CursedPrograms/NORA-Robot-v00/TODO.txt

[done] Implement wheel lock/unlock on the remote - It requires no Password like the webpage.

[done in code, not flashed] Implement speed control on the remote (6 slower, 7 faster, 10 % a press)

Replace the AHT10 sensor and connect it to 3.3V (physical/hardware modification, not code)

[done in code] Add voice response - MP3 lines track200-210 (make_voice.bat). Still to do: copy them to the SD card and upload the UNO sketch.

Add a buzzer

Use the light sensor to turn on the UV light when dark (and off when bright)

[done in code, not flashed: stops at 22 cm, slows from 40, slides off a side wall from 20 cm, only slides under 9 cm] Improve obstacle avoidance (currently inaccurate; the sides scrape walls). It should stop and strafe away if a left/right sensor gets too close to a wall. The stopping distance is also to small it runs into walls.

[done] Use the IR transmitter to steer MILA, KIDA01, WHIP (fleet link, /link?r=&c=, panel tabs)

[done] If not actively transmitting IR commands, continuously broadcast a signal telling other robots: "Hi, I am here" (beacon 0x47, round-robin every 2 s)

WiFi/Windows only — no Bluetooth serial transport (that needs separate serial-port code per platform), and no Linux/macOS HTTP backend (would need libcurl instead of WinHTTP). Both are legitimate follow-ups if you want them later.

[done] Only obey NORA's own IR remote (NEC 0x00) - noise was switching her into Line mode; mode changes record their source (msrc)

[done] Line mode stops for anything closer than 15 cm in front (she drove into a wall)

[done] Web page sends fast (TCP no-delay) - the 10 s send froze her loop and hid her from RIFT

UV BLINK may be restarting her (power dip?) - check if UV ON does it too; drive the UV LED through a transistor

Left ultrasonic reads -1 (no echo) - check its wiring

M:TRACK:<n> (play track n from the start) added to arduino.ino for RIFT's music together - compiles, NOT flashed yet: needs the user's OK (2026-10-14)
