CursedPrograms/NORA-Robot-v00/scripts/esp32/esp32.ino

#include <WiFi.h>
#include <HTTPClient.h>
// WiFi names, passwords and the wheel-lock password: secrets.h (git ignores it),
// else the placeholders in secrets.example.h.
#if __has_include("secrets.h")
#include "secrets.h"
#else
#include "secrets.example.h"
#endif
#include <WebServer.h>
#include <ESPmDNS.h>
#include <Preferences.h>
#include "fleet_bt.h"   // the fleet's one Bluetooth protocol: her whole web API over Bluetooth serial (RIFT/Fleet/esp32)
#include <IRremote.hpp>
#include "avatars.h"
#include "keys_page.h"   // the /keys page: generated from scripts/keymap.py
#include "fleet_near.h"      // ESP-NOW "I'm here" beacons: which robots are nearby, from signal strength
#include "fleet_stay.h"     // STAY CLOSE: keeping near RITA
#include "fleet_near_ble.h"  // ...and the same beacon over Bluetooth LE, so she and the Pi robots (KIDAs) hear each other
#include "fleet_radio.h"     // WiFi or Bluetooth (RIFT switches): all of it at once left her 3.7 KB and she rebooted forever
#include "talk_bf.h"  // the fleet's Brainfuck phrasebook (generated by RIFT/Fleet/brainfuck_talk.py)   // /avatar/<name>.jpg for the fleet-remote panel
#include <Wire.h>
#include <Adafruit_AHTX0.h>

// =====================
// BLUETOOTH
// =====================
// Pair with "NORA" from your phone, then use any Bluetooth serial /
// RC controller app. Single-character commands:
//   F=forward  B=backward  L=strafe left  R=strafe right
//   Q=turn left  E=turn right  S=stop
//   1=manual mode  2=auto mode  3=line mode
//   U=cycle UV     M=music play/pause  N=next track  P=prev track  X=music stop
//   K=lock motors (always allowed)
//   V + 4 chars=unlock motors (password, e.g. "V1234")
//   +=speed up  -=speed down  ?=print sensor + music status
//   H + "name:cap1,cap2" + newline = fleet heartbeat/register (mirrors the
//     HTTP /register the fleet registry below takes over WiFi — lets RIFT
//     or DREAM heartbeat over Bluetooth instead when their dashboards are
//     switched to that transport). Replies "OK" or "ERR".

// =====================
// WIFI
// =====================
// The fleet's ladder: RIFT > DREAM > NINA > TINA (the hub, the virtual bots)
// > NORACTL > WHIPCTL > KIDA01CTL > KIDA00CTL > ARMCTL (the PC controllers, in their bots' order)
// > NORA > WHIP > KIDA01 > KIDA00 > ARM > MILA (the real bots). Every
// robot joins the highest network it sees above itself; with none, it hosts its own
// and the fleet list (/register, /robots on :5000) so the ones below find each other.
// Above NORA are RIFT (FLEET_SSID, the router), DREAM, NINA, TINA and the controllers; everyone uses the
// fleet password. If neither is around she hosts NORA_AP_SSID (192.168.4.1) as before,
// and keeps looking: when a higher network shows up she restarts into it (parked only).
const char* ap_ssid = NORA_AP_SSID;
const char* ap_password = NORA_AP_PASSWORD;
const char* const ABOVE_NORA[] = { FLEET_SSID, "DREAM", "NINA", "TINA", "AURA", "NORACTL", "WHIPCTL", "KIDA01CTL", "KIDA00CTL", "ARMCTL" };   // highest first
const uint16_t RIFT_PORT = 5000;                             // the fleet list, on whoever hosts
const unsigned long FLEET_JOIN_MS = 20000;     // at boot: how long to try RIFT's network
const unsigned long RIFT_SCAN_MS = 30000;      // on her own network: look for RIFT this often
const unsigned long RIFT_REGISTER_MS = 10000;  // on RIFT's network: heartbeat (RIFT drops entries after 20 s)
const unsigned long NET_LOST_MS = 60000;       // the network above her, or its fleet list, silent this long: climb again
bool onRift = false;                           // joined a network above her (false = hosting her own)
int  joinedRank = -1;                          // which: 0 = RIFT, 1 = DREAM, 2 = NINA, 3 = TINA, 4+ = the controllers
WebServer server(5002);

// =====================
// MOTOR PINS
// =====================
#define ENA1 5
#define M1_1 16
#define M1_2 17

#define ENA2 23
#define M2_1 18
#define M2_2 19

#define ENB1 12
#define M3_1 13
#define M3_2 14

#define ENB2 27
#define M4_1 26
#define M4_2 25

// Forward declarations with default args (kept here only — the Arduino IDE
// auto-generates prototypes from the definitions below, and a default
// argument may only be specified once per translation unit).
void moveForward(int scale = 100);
void moveBackward(int scale = 100);
void strafeLeft(int scale = 100);
void strafeRight(int scale = 100);
void turnLeft(int scale = 100);
void turnRight(int scale = 100);
void stopMotors();
void setMotor(int ena, int pin1, int pin2, int s1, int s2, int speed, int scale = 100);
bool motorsMoving = false;   // any wheel driven right now (what she tells the fleet: parked or moving)
// What the UNO last reported about its SD card and music (-1 = an older UNO sketch that doesn't say)
int sdOk = -1, sdTracks = -1;
// The last IR frame heard, whatever it was (shown in /sensors, to see whether a remote is heard and what it sends)
unsigned long irFrames = 0;
String irLastProto = "";
uint16_t irLastAddr = 0;
uint16_t irLastCmd = 0;

// =====================
// LINE FOLLOWER (on ESP32)
// =====================
#define LF_LEFT 34
#define LF_MID 35
#define LF_RIGHT 39

// =====================
// UV LIGHT (on ESP32)
// =====================
#define UV_PIN 4

// =====================
// LIGHT + SOUND SENSORS
// =====================
// Both live on the Arduino now (A5 / pin 5) -- it has to poll the sound
// sensor tightly between ultrasonic pings to catch a clap reliably, which
// its loop is naturally suited for. It forwards smoothed light% and a
// latched sound-event flag over serial (LT / SND fields), parsed below in
// parseSensorLine(). The clap-count/double-clap timing itself still runs
// here, just fed by that flag instead of a local digitalRead edge.
//
// CLAP_BOOT_GRACE_MS: ignore that flag for the first few seconds after
// boot -- the Arduino's own startup chime plays right into the sound
// sensor and reads as a clap otherwise (see parseSensorLine()).
#define CLAP_BOOT_GRACE_MS 5000
int lightPct = 0;          // 0 = dark, 100 = bright
bool soundRecent = false;  // true if a sound was heard in the last 500ms
unsigned long lastSoundMs = 0;
unsigned long firstClapMs = 0;
int clapCount = 0;

// =====================
// TEMPERATURE / HUMIDITY (AHT10, I2C)
// =====================
// Wire.begin() with no args defaults to SDA=21 SCL=22 on the ESP32.
Adafruit_AHTX0 aht;
bool aht10Ok = false;  // if begin() failed, skip reads and leave -1 (matches ultrasonic's "no reading" convention -- NAN would serialize as invalid JSON and silently freeze the whole HUD)
float tempC = -1;
float humidity = -1;

// =====================
// IR RECEIVER (on ESP32)
// =====================
// Cheap NEC remote (see ir_mapping.txt for the full button dump). Data pin
// only — GPIO32 was the next free, non-strapping pin left on the board;
// power the receiver from 3.3V, not 5V, so its output never exceeds the
// ESP32's logic level.
// IR transmitter LED lives on GPIO33 (freed up now that the sound sensor
// moved to the Arduino). It carries the IDA link below.
#define IR_RECEIVE_PIN 32
#define IR_SEND_PIN 33

// =====================
// IDA LINK (NORA -> IDA over IR)
// =====================
// NORA relays drive commands to IDA, which only has an IR receiver. The link
// has its own protocol so nothing else in the fleet reacts to it: Samsung-
// format frames (38 kHz) with address IDA_LINK_ADDRESS, while every remote in
// the fleet is NEC (NORA) or Sony-style (IDA, MILA, WHIP). The command codes
// 0x48-0x4F are unused by all of those remotes too. IDA's side is
// runLinkCommand() in IDA-Robot-v00/scripts/IDA/IDA.ino;
// keep the two tables in step.
// Driving commands must be re-sent every ~150 ms while held (the web page,
// Python controller and BT 'I' prefix all do); IDA stops ~500 ms after they stop.
#define IDA_LINK_ADDRESS 0x0DA1
// The same link drives MILA, WHIP and KIDA-01 too, each on its own address
// (same command codes). Their receivers: MILA.ino and WHIP's esp32.ino
// runLinkCommand(), KIDA-01's arduino01 sketch (prints the IR lines the Pi
// already understands).
#define MILA_LINK_ADDRESS 0x0DA2
#define WHIP_LINK_ADDRESS 0x0DA3
#define KIDA_LINK_ADDRESS 0x0DA4
#define NIKA_LINK_ADDRESS 0x0DA5   // NIKA.ino: like MILA's, plus she listens for this beacon (her social drive)

// ---- Robots talking (liveliness; the real data goes over WiFi / the link) ----
// Every so often, when she isn't driving anyone, NORA says a phrase: she
// beeps it on her buzzer (BZ:TALK:n to the UNO; each phrase is a Brainfuck
// program from talk_bf.h, one tone per symbol) and, once she's finished,
// sends 0x40 + n over the link. IDA answers with her reply (IDA.ino hearNora()). Between phrases a
// silent beacon (0x47, "I am here") goes round-robin to every link robot, so
// they know she's near; IDA greets her when she comes back after a while.
// Every phrase is logged for /talk (and RIFT, later).
#define TALK_FIRST 0x40
#define TALK_BEACON 0x47
const char* const TALK_NAMES[7] = { "hello", "how are you", "happy", "curious", "sleepy", "play", "bye" };
bool chatOff = false;   // her chat switch (/talkmute?chat_off=): out of the conversations
const unsigned long TALK_QUIET_MS = 15000;   // no chatting within 15 s of driving a robot over the link
const unsigned long BEACON_EVERY_MS = 2000;  // one robot per beacon, so each hears it every 8 s
const int TALK_LOG_LEN = 12;
unsigned long talkLogMs[TALK_LOG_LEN];
uint16_t talkLogTo[TALK_LOG_LEN];
uint8_t talkLogPhrase[TALK_LOG_LEN];
int talkLogCount = 0, talkLogNext = 0;
unsigned long lastLinkDriveMs = 0;  // last drive command sent over the link
unsigned long nextTalkMs = 30000;
unsigned long nextBeaconMs = 0;
int beaconIndex = 0;
uint16_t pendingLinkAddr = 0;  // phrase to send over IR once NORA has finished saying it
uint8_t pendingLinkCode = 0;
unsigned long pendingLinkAt = 0;
#define LINK_FORWARD 0x48
#define LINK_BACKWARD 0x49
#define LINK_LEFT 0x4A
#define LINK_RIGHT 0x4B
#define LINK_STOP 0x4C
#define LINK_OBSTACLE 0x4D
#define LINK_MANUAL 0x4E
#define LINK_SPEED 0x4F
// The wheel lock, over the link: NORA can free (or lock) the wheels of a robot she drives.
// Each robot does it in its own way (IDA.ino, MILA.ino, WHIP's esp32.ino, KIDA-01's arduino01).
#define LINK_UNLOCK 0x50
#define LINK_LOCK 0x51

#define IR_UP 0x6
#define IR_LEFT 0x47
#define IR_DOWN 0x44
#define IR_RIGHT 0x40
#define IR_ENTER 0x7
#define IR_1 0x9
#define IR_2 0x1D
#define IR_3 0x1F
#define IR_4 0xD
#define IR_MUTE 0x56
#define IR_VOL_UP 0x3
#define IR_VOL_DOWN 0x2
#define IR_REPEAT 0x53
#define IR_PLAY_PAUSE 0xF
#define IR_STOP 0x42
#define IR_NEXT 0x1A
#define IR_PREV 0xE
#define IR_FFWD 0x1E
#define IR_REWIND 0xA
#define IR_5 0x19   // the wheel lock, on and off: one button, no PIN (the lock is a safety catch, not security)
#define IR_6 0x1B   // slower: speed down 10 %
#define IR_7 0x11   // faster: speed up 10 %

#define IR_DRIVE_TIMEOUT_MS 250  // stop if no drive repeat arrives within this long (no key-up event over IR)

bool irStrafe = true;  // Enter toggles Left/Right between strafe (true) and turn (false)
unsigned long irLastDriveMs = 0;
// Blended driving (/drive?f=&s=&t=): the controller resends it every 150 ms while held, so she
// stops by herself DRIVE_MIX_TIMEOUT_MS after the last one (a closed controller can't leave her running).
#define DRIVE_MIX_TIMEOUT_MS 500
unsigned long driveMixMs = 0;
// The same for /fw ... /turnR, which her page and the controllers resend every 150-200 ms: a page closed or a
// program gone mid-drive would otherwise leave her running. Longer: her one-client server can stall a resend.
#define WEB_DRIVE_TIMEOUT_MS 1500
unsigned long webDriveMs = 0;

// =====================
// DRIVE MODE
// =====================
enum DriveMode { MODE_MANUAL,
                 MODE_AUTO,
                 MODE_LINE,
                 MODE_IR,
                 MODE_MIND,     // her PC controller's LLM drives her (MIND MODE below)
                 MODE_FOLLOW,   // keeps a hand FOLLOW_CM from her front sonar (FOLLOW below)
                 MODE_STAY };   // keeps near RITA, in your hand (STAY CLOSE below)
DriveMode driveMode = MODE_MANUAL;
Stay stay;

// HELLO and DANCE (/act?do=, as WHIP's): a wiggle on the spot, a step at a time from loop(), so her
// web page and the IR keep working. Any stopMotors() ends it.
enum ShowMove { SHOW_NONE, SHOW_HELLO, SHOW_DANCE };
ShowMove showMove = SHOW_NONE;
int showStep = 0;
unsigned long showNextMs = 0;

// =====================
// MIND MODE (fleet TODO, section 10)
// =====================
// Her PC controller's LLM (mind.py) drives her one short move at a time. The mind host - a controller
// that can run it (mind.can_think()) - unlocks with /unlock?pw=<MOTOR_PASSWORD>&ctl=1 and checks in on
// /sensors?ctl=1; MIND mode only starts while it does, and ends (stop, back to MANUAL) 5 s after it goes
// quiet. /mind?act=fw|bw|left|right|turnL|turnR|stop&steps=1-4: MIND_STEP_MS per step, then stop. Her
// wheel lock and her manual wall stop (MANUAL_STOP_CM, any direction) hold in MIND too.
IPAddress mindHostIP(0, 0, 0, 0);
unsigned long mindHostSeen = 0;
const unsigned long MIND_HOST_TTL_MS = 5000;
const unsigned long MIND_STEP_MS = 400;
const int MIND_MAX_STEPS = 4;
unsigned long mindMoveUntil = 0;   // the current move ends here (0 = none)
int mindDir = -1;                  // the DIR_* it's heading, to stop at a wall on the way; -1 = turning
bool mindBlocked = false;          // the last move stopped at a wall
bool mindHostAlive() { return mindHostSeen && millis() - mindHostSeen < MIND_HOST_TTL_MS; }
#define MANUAL_STOP_CM 15.0  // closer than this blocks Manual/Remote driving and pauses Line mode

// =====================
// CALIBRATION & SPEED
// =====================
int cal[4] = { 255, 255, 255, 255 };
int speedPct = 100;
Preferences prefs;

// =====================
// FLEET TEXT MESSAGES
// =====================
// NORA has no display/speaker, so incoming "/message" text just lands in a
// small ring buffer that other fleet nodes (RIFT, DREAM) can poll via
// "/messages" — a lightweight message board rather than something acted on.
#define MESSAGE_LOG_SIZE 10
String messageLog[MESSAGE_LOG_SIZE];
int messageLogHead = 0;
int messageLogCount = 0;

String jsonEscape(const String& in) {
  String out;
  out.reserve(in.length() + 4);
  for (size_t i = 0; i < in.length(); i++) {
    char c = in[i];
    if (c == '"' || c == '\\') out += '\\';
    out += c;
  }
  return out;
}

// =====================
// MOTOR LOCK
// =====================
// Starts locked on every boot so a static-feature test session can never
// accidentally drive off a counter (this is why it exists — see incident).
// Locking is always allowed with no password; unlocking requires one,
// checked here in firmware so every client (web, pygame, raw BT/HTTP)
// is held to the same gate instead of trusting each app to enforce it.
bool motorLocked = true;

// === RADAR (passive imposter spotter) ===
// NORA listens to the WiFi around her and flags anything that is not one of
// our own networks as an "imposter". Passive only: she scans and reports,
// never connecting to or touching a network that is not hers.
const char* const FLEET_SSIDS[] = { "NORA", "MILA", "WHIP", "NIKA" };
// On-demand only: a WiFi scan channel-hops, which would disturb NORA's AP and
// her ESP-NOW proximity beacons, so she scans only when /radar is opened, and
// no more often than this.
const unsigned long RADAR_MIN_GAP_MS = 10000;
String radarJson = "{\"scanning\":false,\"nets\":[]}";
unsigned long lastRadarScan = 0;
bool radarInFlight = false;
bool radarRequested = false;

bool isFleetSsid(const String& s) {
  for (unsigned i = 0; i < sizeof(FLEET_SSIDS) / sizeof(FLEET_SSIDS[0]); i++) {
    if (s == FLEET_SSIDS[i]) return true;
  }
  return false;
}

String radarEscape(const String& in) {
  String out;
  for (unsigned i = 0; i < in.length(); i++) {
    char c = in[i];
    if (c == '"' || c == '\\') { out += '\\'; out += c; }
    else if (c == '\n' || c == '\r' || c == '\t') { out += ' '; }
    else out += c;
  }
  return out;
}

void radarLoop() {
  if (!radarInFlight && radarRequested && millis() - lastRadarScan >= RADAR_MIN_GAP_MS) {
    radarRequested = false;
    WiFi.scanNetworks(true, true);   // async, include hidden
    radarInFlight = true;
    lastRadarScan = millis();
    return;
  }
  if (radarInFlight) {
    int n = WiFi.scanComplete();
    if (n == WIFI_SCAN_RUNNING) return;
    if (n == WIFI_SCAN_FAILED)  { radarInFlight = false; return; }
    int imposters = 0;
    String j = "{\"scanning\":false,\"nets\":[";
    for (int i = 0; i < n; i++) {
      String ssid = WiFi.SSID(i);
      String shown = ssid.length() ? radarEscape(ssid) : "(hidden)";
      bool fleet = ssid.length() && isFleetSsid(ssid);
      if (!fleet) imposters++;
      if (i) j += ",";
      j += "{\"ssid\":\"" + shown + "\",\"rssi\":" + String(WiFi.RSSI(i)) +
           ",\"imposter\":" + String(fleet ? "false" : "true") + "}";
    }
    j += "],\"imposters\":" + String(imposters) + "}";
    radarJson = j;
    WiFi.scanDelete();
    radarInFlight = false;
  }
}

// Fleet heartbeat over Bluetooth ('H' below) — same buffer-until-newline
// shape as the password flow above, just terminated by '\n' instead of a
// fixed length since the payload ("name:cap1,cap2") is variable-length.

// =====================
// AUTONOMOUS STATE
// =====================
#define DIR_FRONT 0
#define DIR_RIGHT 1
#define DIR_BACK 2
#define DIR_LEFT 3

enum AutoState { AUTO_COOLDOWN,
                 AUTO_MOVING };
AutoState autoState = AUTO_COOLDOWN;
int autoDir = DIR_FRONT;
unsigned long autoCooldown = 0;

// boxed-in tracking for AutonomousMode() — global (not function-static) so
// entering Auto mode can reset it; otherwise a stale timestamp from a past
// stuck episode could fire an escape turn immediately on re-entry
unsigned long autoStuckSinceMs = 0;
bool autoEscaping = false;
unsigned long autoEscapeUntilMs = 0;

// =====================
// LINE FOLLOWER STATE
// =====================
// global (not function-static) so entering Line mode can reset it —
// otherwise a stale "lost the line" timestamp from a past run could fire
// an immediate stop on re-entry instead of the intended grace period
int lineLastTurn = 1;
unsigned long lineLostSinceMs = 0;

// =====================
// FLEET REGISTRY (port 5000)
// =====================
// NORA is the always-on node at a fixed address, so she's the natural
// place for robots (and a fleet manager like RIFT, if one's running) to
// find each other, instead of every app brute-force-scanning the subnet.
//
//   GET  /ping      -> liveness check
//   POST /register  -> body: name, type, capabilities (comma-separated)
//   GET  /robots    -> {"authority": "...", "robots": [...]}
//
// If something registers with type "fleet_manager" (e.g. RIFT), NORA
// treats it as the fleet's source of truth: she keeps quietly bookkeeping
// whoever else registers, but stops *surfacing* her own roster in
// /robots — callers get pointed at the authority instead. The moment
// the authority's heartbeat lapses (it closed, crashed, or the network
// dropped), NORA reclaims the role automatically and starts serving her
// own roster again. No explicit handoff needed either direction.
#define FLEET_MAX 8
#define FLEET_TTL_MS 20000  // drop an entry (or the authority) after this long without a heartbeat

struct FleetEntry {
  bool used = false;
  String name;
  String type;
  String capabilities;  // as given, comma-separated
  IPAddress ip;
  unsigned long lastSeenMs = 0;
};

FleetEntry fleet[FLEET_MAX];
WebServer fleetServer(5000);

String authorityName = "NORA";
unsigned long authorityExpiresMs = 0;  // 0 = NORA herself is the authority

// =====================
// SENSOR VALUES
// =====================
float front_cm = -1, left_cm = -1, back_cm = -1, right_cm = -1;
int lf_l = 0, lf_m = 0, lf_r = 0;
String serialBuffer = "";

// =====================
// MUSIC STATE (reported by Arduino)
// =====================
int musicTrack = 100;  // current track number
int musicState = 0;    // 0=stopped 1=playing 2=paused

// =====================
// UV STATE
// =====================
int uvMode = 0;  // 0=off 1=on 2=blink
bool uvBlinkState = false;
unsigned long lastUVBlink = 0;

// =====================
// BUZZER NOTIFICATIONS
// =====================
// The buzzer itself is on the Arduino (pin 10), but the state it needs to
// react to (mode/UV/lock/speed) all lives here -- so every place that
// changes one of those calls the matching notify*() right after, and it
// travels over the same serial link as the M:*/V:* commands.
void notifyMode() {
  if (driveMode == MODE_FOLLOW || driveMode == MODE_STAY) {   // the UNO's mode lines are 0-3: she says hello instead
    Serial.println("BZ:TALK:0");
    return;
  }
  if (driveMode == MODE_MIND) {   // the UNO's mode lines are 0-3; "Mind mode." is phrase-book line 11
    Serial.println("SAY:11");
    return;
  }
  Serial.print("BZ:MODE:");
  Serial.println((int)driveMode);
}
void notifyUv() {
  Serial.print("BZ:UV:");
  Serial.println(uvMode);
}
void notifyLock() {
  Serial.print("BZ:LOCK:");
  Serial.println(motorLocked ? 1 : 0);
}
void notifySpeed() {
  Serial.print("BZ:SPD:");
  Serial.println(speedPct);
}

// Every mode change goes through here, and remembers who asked for it
// ("web", "bt", "ir") -- shown as "msrc" in /sensors and BT '?', so a mode
// nobody chose can be traced back to where it came from.
String modeSource = "boot";

void setDriveMode(DriveMode m, const String& src) {
  driveMode = m;
  modeSource = src;
  stopMotors();
  if (m == MODE_AUTO) {
    autoState = AUTO_COOLDOWN;
    autoCooldown = 0;
    autoStuckSinceMs = 0;
    autoEscaping = false;
  } else if (m == MODE_LINE) {
    lineLostSinceMs = 0;
  } else if (m == MODE_IR) {
    irLastDriveMs = 0;
  } else if (m == MODE_STAY) {
    stayStart(stay);
  }
  notifyMode();
}

// =====================
// SETUP
// =====================
void handleRoot();   // after the page: Arduino's prototype maker can lose it in that much text

void setup() {
  Serial.begin(9600);  // link to Arduino (sensors in, music commands out)

  prefs.begin("cal", true);
  cal[0] = prefs.getInt("m1", 255);
  cal[1] = prefs.getInt("m2", 255);
  cal[2] = prefs.getInt("m3", 255);
  cal[3] = prefs.getInt("m4", 255);
  speedPct = prefs.getInt("spd", 100);
  prefs.end();
  prefs.begin("talk", true);   // her Brainfuck talking muted? (/talkmute, RIFT's Fleet/talk_mute.py)
  talkMuted = prefs.getBool("muted", false);
  chatOff = prefs.getBool("chatoff", false);
  prefs.end();

  randomSeed(esp_random());  // the conversations shouldn't repeat every boot
  fleetRadioBegin();   // WiFi (default) or Bluetooth, as RIFT last set it; on WiFi Bluetooth's RAM goes back
  if (fleetRadioWifi()) setupWiFi();   // RIFT's network, or her own (ESP-NOW rides on whichever)
  else fleetRadioNoWifi();             // Bluetooth: no WiFi at all (MILA and NIKA can't reach her then)
  IrReceiver.begin(IR_RECEIVE_PIN, DISABLE_LED_FEEDBACK);
  // The transmitter makes its carrier with an LEDC channel and the receiver
  // samples on a hardware timer, so they don't contend on the ESP32.
  // idaSend() still pauses the receiver for each frame so NORA doesn't
  // decode her own transmission.
  IrSender.begin(IR_SEND_PIN);

  Wire.begin();
  aht10Ok = aht.begin();  // if missing, tempC/humidity just stay -1

  pinMode(ENA1, OUTPUT);
  pinMode(M1_1, OUTPUT);
  pinMode(M1_2, OUTPUT);
  pinMode(ENA2, OUTPUT);
  pinMode(M2_1, OUTPUT);
  pinMode(M2_2, OUTPUT);
  pinMode(ENB1, OUTPUT);
  pinMode(M3_1, OUTPUT);
  pinMode(M3_2, OUTPUT);
  pinMode(ENB2, OUTPUT);
  pinMode(M4_1, OUTPUT);
  pinMode(M4_2, OUTPUT);

  pinMode(LF_LEFT, INPUT);
  pinMode(LF_MID, INPUT);
  pinMode(LF_RIGHT, INPUT);

  pinMode(UV_PIN, OUTPUT);
  digitalWrite(UV_PIN, LOW);

  // Manual movement
  server.on("/fw", []() {
    if (driveMode == MODE_MANUAL) { moveForward(); webDriveMs = millis(); }
    server.send(200, "text/plain", "OK");
  });
  server.on("/bw", []() {
    if (driveMode == MODE_MANUAL) { moveBackward(); webDriveMs = millis(); }
    server.send(200, "text/plain", "OK");
  });
  server.on("/left", []() {
    if (driveMode == MODE_MANUAL) { strafeLeft(); webDriveMs = millis(); }
    server.send(200, "text/plain", "OK");
  });
  server.on("/right", []() {
    if (driveMode == MODE_MANUAL) { strafeRight(); webDriveMs = millis(); }
    server.send(200, "text/plain", "OK");
  });
  server.on("/turnL", []() {
    if (driveMode == MODE_MANUAL) { turnLeft(); webDriveMs = millis(); }
    server.send(200, "text/plain", "OK");
  });
  server.on("/turnR", []() {
    if (driveMode == MODE_MANUAL) { turnRight(); webDriveMs = millis(); }
    server.send(200, "text/plain", "OK");
  });
  server.on("/stop", []() {
    if (driveMode == MODE_MANUAL) stopMotors();
    server.send(200, "text/plain", "OK");
  });
  // Blended: f forward, s sideways (+ left), t turn (+ anticlockwise), each -1..1, all at once
  // (W+A drives forward and slides left; W+Q curves). Resent while held; see DRIVE_MIX_TIMEOUT_MS.
  server.on("/drive", []() {
    if (driveMode == MODE_MANUAL) {
      driveMix(constrain(server.arg("f").toFloat(), -1.0f, 1.0f), constrain(server.arg("s").toFloat(), -1.0f, 1.0f),
               constrain(server.arg("t").toFloat(), -1.0f, 1.0f));
      driveMixMs = millis();
    }
    server.send(200, "text/plain", "OK");
  });

  // Mode switching
  server.on("/modeManual", []() {
    setDriveMode(MODE_MANUAL, "web");
    server.send(200, "text/plain", "OK");
  });
  server.on("/modeAuto", []() {
    setDriveMode(MODE_AUTO, "web");
    server.send(200, "text/plain", "OK");
  });
  server.on("/modeLine", []() {
    setDriveMode(MODE_LINE, "web");
    server.send(200, "text/plain", "OK");
  });
  server.on("/modeIR", []() {
    setDriveMode(MODE_IR, "web");
    server.send(200, "text/plain", "OK");
  });
  server.on("/modeFollow", []() {
    setDriveMode(MODE_FOLLOW, "web");
    server.send(200, "text/plain", "OK");
  });
  server.on("/modeStay", []() {
    setDriveMode(MODE_STAY, "web");
    server.send(200, "text/plain", "OK");
  });
  server.on("/act", []() {         // ?do=hello|dance, in MANUAL, as WHIP's
    const String what = server.arg("do");
    if (what != "hello" && what != "dance") { server.send(400, "text/plain", "hello|dance"); return; }
    if (driveMode != MODE_MANUAL) { server.send(409, "text/plain", "only in MANUAL"); return; }
    startShow(what == "hello" ? SHOW_HELLO : SHOW_DANCE);
    server.send(200, "text/plain", "OK");
  });
  server.on("/modeMind", []() {    // the MIND button (her page, her controller): only while her mind's controller is here
    if (!mindHostAlive()) { server.send(409, "text/plain", "no mind controller running"); return; }
    setDriveMode(MODE_MIND, "mind");
    server.send(200, "text/plain", "OK");
  });
  server.on("/mode", []() {        // the fleet's /mode?m=mind (and her other modes by name)
    String m = server.arg("m");
    if (m == "mind") {
      if (!mindHostAlive()) { server.send(409, "text/plain", "no mind controller running"); return; }
      setDriveMode(MODE_MIND, "mind");
    } else if (m == "manual") setDriveMode(MODE_MANUAL, "web");
    else if (m == "auto") setDriveMode(MODE_AUTO, "web");
    else if (m == "line") setDriveMode(MODE_LINE, "web");
    else if (m == "ir") setDriveMode(MODE_IR, "web");
    else if (m == "follow") setDriveMode(MODE_FOLLOW, "web");
    else if (m == "stay") setDriveMode(MODE_STAY, "web");
    else { server.send(400, "text/plain", "manual|auto|line|ir|follow|stay|mind"); return; }
    server.send(200, "text/plain", "OK");
  });
  server.on("/unlock", []() {      // her mind's controller says it's here (her PIN = her motor password)
    if (server.arg("pw") != MOTOR_PASSWORD) { server.send(403, "application/json", "{\"ok\":false}"); return; }
    if (server.arg("ctl") == "1") { mindHostIP = server.client().remoteIP(); mindHostSeen = millis(); }
    server.send(200, "application/json", "{\"ok\":true}");
  });
  server.on("/mind", []() {
    if (!mindHostAlive() || server.client().remoteIP() != mindHostIP) { server.send(403, "text/plain", "LOCKED"); return; }
    if (driveMode != MODE_MIND) { server.send(409, "application/json", "{\"ok\":false,\"error\":\"not in mind mode\"}"); return; }
    String act = server.arg("act");
    int steps = server.hasArg("steps") ? constrain(server.arg("steps").toInt(), 1, MIND_MAX_STEPS) : 1;
    if (act == "stop") { stopMotors(); mindMoveUntil = 0; server.send(200, "application/json", "{\"ok\":true}"); return; }
    if (motorLocked) { server.send(200, "application/json", "{\"ok\":false,\"locked\":true}"); return; }
    int dir = act == "fw" ? DIR_FRONT : act == "bw" ? DIR_BACK : act == "left" ? DIR_LEFT : act == "right" ? DIR_RIGHT : -1;
    if (dir < 0 && act != "turnL" && act != "turnR") { server.send(400, "application/json", "{\"ok\":false,\"error\":\"bad act\"}"); return; }
    mindBlocked = dir >= 0 && blockedInDir(dir);
    if (mindBlocked) { server.send(200, "application/json", "{\"ok\":false,\"blocked\":true}"); return; }
    if (act == "fw") moveForward();
    else if (act == "bw") moveBackward();
    else if (act == "left") strafeLeft();
    else if (act == "right") strafeRight();
    else if (act == "turnL") turnLeft();
    else turnRight();
    mindDir = dir;
    mindMoveUntil = millis() + steps * MIND_STEP_MS;
    server.send(200, "application/json", "{\"ok\":true}");
  });

  // UV
  server.on("/uvOff", []() {
    uvMode = 0;
    notifyUv();
    server.send(200, "text/plain", "OK");
  });
  server.on("/uvOn", []() {
    uvMode = 1;
    notifyUv();
    server.send(200, "text/plain", "OK");
  });
  server.on("/uvBlink", []() {
    uvMode = 2;
    notifyUv();
    server.send(200, "text/plain", "OK");
  });

  // Motor lock — lock is free, unlock needs the password
  server.on("/motorlockOn", []() {
    motorLocked = true;
    stopMotors();
    notifyLock();
    server.send(200, "text/plain", "OK");
  });
  server.on("/motorlockOff", []() {
    if (server.hasArg("pw") && server.arg("pw") == MOTOR_PASSWORD) {
      motorLocked = false;
      notifyLock();
      server.send(200, "text/plain", "OK");
    } else {
      server.send(403, "text/plain", "DENIED");
    }
  });

  // Music player -> forwarded to Arduino over serial
  server.on("/muPlay", []() {
    Serial.println("M:PLAY");
    server.send(200, "text/plain", "OK");
  });
  server.on("/muNext", []() {
    Serial.println("M:NEXT");
    server.send(200, "text/plain", "OK");
  });
  server.on("/muPrev", []() {
    Serial.println("M:PREV");
    server.send(200, "text/plain", "OK");
  });
  server.on("/muStop", []() {
    Serial.println("M:STOP");
    server.send(200, "text/plain", "OK");
  });

  // Generic serial passthrough — lets fleet controllers (RIFT, DREAM)
  // send any command string straight to the onboard Arduino over UART,
  // beyond the hardcoded M:*/UV:* commands above.
  server.on("/serial", []() {
    if (!server.hasArg("cmd")) {
      server.send(400, "text/plain", "missing 'cmd'");
      return;
    }
    Serial.println(server.arg("cmd"));
    server.send(200, "text/plain", "OK");
  });

  // Text message board (see MESSAGE_LOG_SIZE above).
  server.on("/message", HTTP_POST, []() {
    if (!server.hasArg("text")) {
      server.send(400, "text/plain", "missing 'text'");
      return;
    }
    messageLog[messageLogHead] = server.arg("text");
    messageLogHead = (messageLogHead + 1) % MESSAGE_LOG_SIZE;
    if (messageLogCount < MESSAGE_LOG_SIZE) messageLogCount++;
    server.send(200, "text/plain", "OK");
  });
  server.on("/messages", HTTP_GET, []() {
    String json = "[";
    for (int i = 0; i < messageLogCount; i++) {
      int idx = (messageLogHead - messageLogCount + i + MESSAGE_LOG_SIZE) % MESSAGE_LOG_SIZE;
      if (i > 0) json += ",";
      json += "\"" + jsonEscape(messageLog[idx]) + "\"";
    }
    json += "]";
    server.send(200, "application/json", json);
  });

  // Calibration
  server.on("/setcal", []() {
    if (server.hasArg("m1")) cal[0] = constrain(server.arg("m1").toInt(), 0, 255);
    if (server.hasArg("m2")) cal[1] = constrain(server.arg("m2").toInt(), 0, 255);
    if (server.hasArg("m3")) cal[2] = constrain(server.arg("m3").toInt(), 0, 255);
    if (server.hasArg("m4")) cal[3] = constrain(server.arg("m4").toInt(), 0, 255);
    server.send(200, "text/plain", "OK");
  });
  server.on("/setspeed", []() {
    if (server.hasArg("v")) {
      speedPct = constrain(server.arg("v").toInt(), 0, 100);
      notifySpeed();
    }
    server.send(200, "text/plain", "OK");
  });
  server.on("/savecal", []() {
    prefs.begin("cal", false);
    prefs.putInt("m1", cal[0]);
    prefs.putInt("m2", cal[1]);
    prefs.putInt("m3", cal[2]);
    prefs.putInt("m4", cal[3]);
    prefs.putInt("spd", speedPct);
    prefs.end();
    server.send(200, "text/plain", "OK");
  });
  server.on("/getcal", []() {
    String json = "{\"m1\":" + String(cal[0]) + ",\"m2\":" + String(cal[1]) + ",\"m3\":" + String(cal[2]) + ",\"m4\":" + String(cal[3]) + ",\"spd\":" + String(speedPct) + "}";
    server.send(200, "application/json", json);
  });

  // /status is the fleet's name for it (fleet talk's "ask", the same JSON). rev: her settings in one
  // number (FNV-1a, as WHIP's), so a page or program sees at once that something changed elsewhere.
  auto sensorsJson = []() {
    if (server.arg("ctl") == "1" && mindHostSeen && server.client().remoteIP() == mindHostIP) mindHostSeen = millis();
    uint32_t rev = 2166136261u;
    const int settings[] = { (int)driveMode, speedPct, uvMode, motorLocked ? 1 : 0, cal[0], cal[1], cal[2], cal[3] };
    for (int v : settings) { rev ^= (uint32_t)v; rev *= 16777619u; }
    String json = "{\"rev\":" + String(rev) + ",\"mindHost\":" + String(mindHostAlive() ? 1 : 0) +
                  ",\"mindSteps\":" + String(mindMoveUntil ? (int)((mindMoveUntil - millis() + MIND_STEP_MS - 1) / MIND_STEP_MS) : 0) +
                  ",\"blocked\":" + String(mindBlocked ? 1 : 0) + ",\"F\":" + String(front_cm, 1) + ",\"L\":" + String(left_cm, 1) + ",\"B\":" + String(back_cm, 1) + ",\"R\":" + String(right_cm, 1) + ",\"lfl\":" + String(lf_l) + ",\"lfm\":" + String(lf_m) + ",\"lfr\":" + String(lf_r) + ",\"mode\":" + String((int)driveMode) + ",\"dir\":" + String(autoDir) + ",\"uv\":" + String(uvMode) + ",\"mt\":" + String(musicTrack) + ",\"ms\":" + String(musicState) + ",\"lt\":" + String(lightPct) + ",\"snd\":" + String(soundRecent ? 1 : 0) + ",\"lock\":" + String(motorLocked ? 1 : 0) + ",\"moving\":" + String(motorsMoving ? 1 : 0) + ",\"spd\":" + String(speedPct) + ",\"temp\":" + String(tempC, 1) + ",\"hum\":" + String(humidity, 1) + ",\"msrc\":\"" + modeSource + "\"" +
                  ",\"sd\":" + String(sdOk) + ",\"nt\":" + String(sdTracks) +
                  ",\"irn\":" + String(irFrames) + ",\"irp\":\"" + irLastProto + "\",\"ira\":" + String(irLastAddr) +
                  ",\"irc\":" + String(irLastCmd) +
                  ",\"distance_cm\":" + String(front_cm, 1) +                                       // her front, for RITA's STATS
                  ",\"wifi_rssi\":" + String(WiFi.status() == WL_CONNECTED ? WiFi.RSSI() : 0) +   // her signal (0: she hosts)
                  ",\"bluetooth\":" + String(fleetRadioBluetooth() && fleetBtConnected() ? 1 : 0) + ",\"radio\":\"" + (fleetRadioBluetooth() ? "bluetooth" : "wifi") + "\"" + ",\"talk_muted\":" + (talkMuted ? "true" : "false") + ",\"chat_off\":" + (chatOff ? "true" : "false") + "}";
    server.send(200, "application/json", json);
  };
  server.on("/sensors", sensorsJson);
  server.on("/status", sensorsJson);

  // ---- IDA link: drive IDA through the IR transmitter (works in every mode,
  // and isn't affected by NORA's motor lock -- they're IDA's motors) ----
  server.on("/ida", []() {
    if (server.hasArg("c") && idaCommand(server.arg("c"))) server.send(200, "text/plain", "OK");
    else server.send(400, "text/plain", "use /ida?c=fw|bw|left|right|stop|auto|manual|speed");
  });
  // ---- fleet link: the same commands for any robot NORA can reach over IR ----
  server.on("/link", []() {
    uint16_t addr = linkAddress(server.arg("r"));
    if (addr && server.hasArg("c") && linkCommand(addr, server.arg("c"))) server.send(200, "text/plain", "OK");
    else server.send(400, "text/plain", "use /link?r=ida|mila|whip|kida&c=fw|bw|left|right|stop|auto|manual|speed");
  });
  // ---- robots talking: GET /talk = the log; /talk?r=ida&p=hello = say it now ----
  server.on("/talk", []() {
    if (server.hasArg("p")) {
      uint16_t addr = linkAddress(server.hasArg("r") ? server.arg("r") : String("ida"));
      int phrase = talkPhrase(server.arg("p"));
      if (!addr || phrase < 0) {
        server.send(400, "text/plain", "use /talk?r=ida|mila|whip|kida&p=hello|how|happy|curious|sleepy|play|bye");
        return;
      }
      talkSay(addr, phrase);
    }
    server.send(200, "application/json", talkJson());
  });
  // ---- /chirp?u=<0-13>: say an utterance on NORA's buzzer (RIFT's WiFi
  // conversations; she doesn't send anything over IR for these) ----
  // ---- /talkmute: her two talk switches (RIFT's Fleet/talk_mute.py, the
  // switches on her page), kept across restarts. ?on=0|1|toggle: sound (she
  // chats, but the buzzer stays quiet; the UNO hears BZ:MUTE:<0|1>, again every
  // 5 s with BZ:PROX). ?chat_off=0|1|toggle: out of the conversations (RIFT's,
  // and her own IR chats with IDA) ----
  server.on("/talkmute", []() {
    if (server.hasArg("on") || server.hasArg("chat_off")) {
      if (server.hasArg("on")) talkMuted = server.arg("on") == "toggle" ? !talkMuted : server.arg("on").toInt() != 0;
      if (server.hasArg("chat_off")) chatOff = server.arg("chat_off") == "toggle" ? !chatOff : server.arg("chat_off").toInt() != 0;
      prefs.begin("talk", false);
      prefs.putBool("muted", talkMuted);
      prefs.putBool("chatoff", chatOff);
      prefs.end();
      Serial.print("BZ:MUTE:");
      Serial.println(talkMuted ? 1 : 0);
    }
    server.send(200, "application/json", talkSwitchJson());
  });
  server.on("/chirp", []() {
    if (chatOff) {
      server.send(409, "application/json", "{\"ok\":false,\"reason\":\"chat_off\"}");
      return;
    }
    if (talkMuted) {   // said, without the buzzer
      server.send(200, "application/json", "{\"ok\":true,\"silent\":true}");
      return;
    }
    int u = server.hasArg("u") ? server.arg("u").toInt() : -1;
    if (!server.hasArg("u") || u < 0 || u >= TALK_UTTERANCES) {
      server.send(400, "text/plain", "use /chirp?u=0-13");
      return;
    }
    Serial.print("BZ:TALK:");
    Serial.println(u);
    server.send(200, "application/json", "{\"ok\":true,\"text\":\"" + String(TALK_TEXT[u]) + "\",\"bf\":\"" + talkProgram(u) + "\",\"ms\":" + String(talkDurationMs(u)) + "}");
  });
  server.on("/avatar/ida.jpg", []() {
    sendAvatar(AVATAR_IDA, sizeof(AVATAR_IDA));
  });
  server.on("/avatar/mila.jpg", []() {
    sendAvatar(AVATAR_MILA, sizeof(AVATAR_MILA));
  });
  server.on("/avatar/whip.jpg", []() {
    sendAvatar(AVATAR_WHIP, sizeof(AVATAR_WHIP));
  });
  server.on("/avatar/kida.jpg", []() {
    sendAvatar(AVATAR_KIDA, sizeof(AVATAR_KIDA));
  });
  server.on("/avatar/nika.jpg", []() {
    sendAvatar(AVATAR_NIKA, sizeof(AVATAR_NIKA));
  });

  // which robots are nearby (ESP-NOW signal strength), nearest first
  server.on("/radar", []() {
    radarRequested = true;   // trigger a fresh scan on the next loop
    server.send(200, "application/json", radarJson);
  });
  server.on("/near", []() {
    server.send(200, "application/json", fleetNearStatusJson());
  });

  server.on("/keys", []() { server.send_P(200, "text/html", KEYS_HTML); });   // every key, button and letter (keys_page.h)
  server.on("/", handleRoot);
  server.begin();
  fleetRadioRoutes(server, MOTOR_PASSWORD);   // /radio: RIFT moves her to Bluetooth and back
  if (fleetRadioBluetooth()) {
    fleetBtBegin("NORA", 5002);   // Bluetooth "NORA": her whole web API over it
    fleetNearBleBegin("NORA");    // and "I'm here" over BLE, in place of ESP-NOW
    return;                       // no fleet list or nora.local without WiFi
  }
  if (MDNS.begin("nora")) MDNS.addService("http", "tcp", 5002);   // nora.local, as MILA and NIKA have

  setupFleetServer();
}

// =====================
// LOOP
// =====================
void loop() {
  // what she tells the other robots: driving herself, driven by you, or parked
  bool selfDriving = driveMode == MODE_STAY || driveMode == MODE_AUTO || driveMode == MODE_LINE || driveMode == MODE_MIND || driveMode == MODE_FOLLOW;
  fleetNearSetState((motorLocked || (!motorsMoving && !selfDriving)) ? FLEET_PARKED
                    : selfDriving ? FLEET_DRIVING : FLEET_USER);

  // The UNO's "something's close" tone only while she's moving and unlocked:
  // tell it when that changes, and every 5 s in case it rebooted.
  static int proxSent = -1;
  static unsigned long proxSentMs = 0;
  int proxNow = (!motorLocked && (motorsMoving || selfDriving)) ? 1 : 0;
  if (proxNow != proxSent || millis() - proxSentMs > 5000) {
    Serial.print("BZ:PROX:");
    Serial.println(proxNow);
    Serial.print("BZ:MUTE:");    // her talking muted? (the UNO keeps no settings of its own)
    Serial.println(talkMuted ? 1 : 0);
    proxSent = proxNow;
    proxSentMs = millis();
  }
  if (fleetRadioWifi()) fleetNearLoop();   // ESP-NOW on WiFi,
  else fleetNearBleLoop();                  // the BLE beacon on Bluetooth
  radarLoop();
  server.handleClient();
  if (fleetRadioWifi()) {
    fleetServer.handleClient();
    fleetNetworkLoop();
  }
  handleIR();
  readSerialSensors();

  lf_l = digitalRead(LF_LEFT);
  lf_m = digitalRead(LF_MID);
  lf_r = digitalRead(LF_RIGHT);

  unsigned long now = millis();
  talkTick(now);

  // IR has no key-up event — a held button just keeps resending, and
  // releasing it simply stops the resends. So if we're driving off the IR
  // remote and haven't seen a repeat in a while, treat that as "released".
  if (driveMode == MODE_IR && irLastDriveMs != 0 && now - irLastDriveMs > IR_DRIVE_TIMEOUT_MS) {
    stopMotors();
    irLastDriveMs = 0;
  }
  if (driveMixMs != 0 && now - driveMixMs > DRIVE_MIX_TIMEOUT_MS) {   // /drive went quiet: let go
    driveMixMs = 0;
    if (driveMode == MODE_MANUAL) stopMotors();
  }
  if (webDriveMs != 0 && now - webDriveMs > WEB_DRIVE_TIMEOUT_MS) {   // /fw ... went quiet: let go
    webDriveMs = 0;
    if (driveMode == MODE_MANUAL) stopMotors();
  }

  // ---- Sound recency decay (the event itself is latched in parseSensorLine) ----
  soundRecent = (now - lastSoundMs) < 500;

  // ---- Single clap (confirmed once the 0.8s double-clap window passes with
  // no second clap) -> play music. Can't fire this the instant a clap is
  // seen, or it'd also fire on the first half of every double clap.
  // Guarded on musicState so it only starts/resumes -- M:PLAY toggles to
  // pause if sent while already playing, which isn't what "1 clap = play"
  // should do. ----
  if (clapCount == 1 && now - firstClapMs > 800) {
    if (musicState != 1) Serial.println("M:PLAY");  // 1 = already playing
    clapCount = 0;
  }

  // ---- Temperature / humidity (AHT10) ----
  static unsigned long lastAhtMs = 0;
  if (aht10Ok && now - lastAhtMs >= 500) {
    sensors_event_t humEvt, tempEvt;
    aht.getEvent(&humEvt, &tempEvt);
    tempC = tempEvt.temperature;
    humidity = humEvt.relative_humidity;
    lastAhtMs = now;
  }

  if (uvMode == 0) {
    digitalWrite(UV_PIN, LOW);
  } else if (uvMode == 1) {
    digitalWrite(UV_PIN, HIGH);
  } else if (now - lastUVBlink >= 300) {
    uvBlinkState = !uvBlinkState;
    digitalWrite(UV_PIN, uvBlinkState ? HIGH : LOW);
    lastUVBlink = now;
  }

  if (driveMode == MODE_AUTO) AutonomousMode(front_cm, left_cm, back_cm, right_cm);
  else if (driveMode == MODE_LINE) LineFollowerMode(lf_l, lf_m, lf_r);
  else if (driveMode == MODE_FOLLOW) FollowMode(front_cm);
  else if (driveMode == MODE_STAY) StayMode(front_cm, left_cm, right_cm);
  else if (showMove != SHOW_NONE) showTick();
  else if (driveMode == MODE_MIND) {
    if (!mindHostAlive()) {
      mindMoveUntil = 0;
      setDriveMode(MODE_MANUAL, "mind gone");   // stops her
    } else if (mindMoveUntil && ((long)(now - mindMoveUntil) >= 0 || (mindDir >= 0 && blockedInDir(mindDir)) || motorLocked)) {
      if (mindDir >= 0 && blockedInDir(mindDir)) mindBlocked = true;
      mindMoveUntil = 0;
      stopMotors();
    }
  }
}

// =====================
// FOLLOW (WHIP's follow-me): keep a hand 30 cm from her front sonar
// =====================
const float FOLLOW_CM = 30;
const float FOLLOW_DEADBAND_CM = 4;   // close enough: stand
const float FOLLOW_LOST_CM = 80;      // nothing nearer than this: nobody to follow, stand

void FollowMode(float front) {
  const float e = front - FOLLOW_CM;
  const int dir = e > 0 ? DIR_FRONT : DIR_BACK;
  if (front <= 0 || front > FOLLOW_LOST_CM || fabs(e) <= FOLLOW_DEADBAND_CM || blockedInDir(dir)) {
    if (motorsMoving) stopMotors();
    return;
  }
  const int scale = constrain(45 + (int)fabs(e) * 2, 45, 80);   // slower as the hand gets close
  if (e > 0) moveForward(scale);
  else moveBackward(scale);
}

// =====================
// STAY CLOSE: near RITA, in your hand (fleet_stay.h)
// =====================
const int STAY_SCALE = 55;

// Her four ultrasonics and her mecanum wheels: she slows near things, slides round them toward the
// side with more room (still facing RITA's signal), and backs out of a corner (fleet_stay.h)
void StayMode(float front, float left, float right) {
  float rssi = -100;
  const bool heard = fleetNearHeard(STAY_PEER, STAY_LOST_MS, &rssi);
  const StaySight sight = { front, left, right, true };
  switch (stayStepSmart(stay, heard, rssi, sight, millis())) {
    case STAY_WALK:        moveForward(STAY_SCALE);           break;
    case STAY_CREEP:       moveForward(STAY_SCALE * 2 / 3);   break;   // something ahead: carefully
    case STAY_LEFT:        turnLeft(STAY_SCALE);              break;
    case STAY_RIGHT:       turnRight(STAY_SCALE);             break;
    case STAY_SLIDE_LEFT:  strafeLeft(STAY_SCALE);            break;
    case STAY_SLIDE_RIGHT: strafeRight(STAY_SCALE);           break;
    case STAY_BACK:        moveBackward(STAY_SCALE * 2 / 3);  break;
    default:               if (motorsMoving) stopMotors();
  }
}

// =====================
// HELLO and DANCE
// =====================
const int SHOW_HELLO_STEPS = 6;   // a wiggle from side to side
const int SHOW_DANCE_STEPS = 12;  // spin left, spin right, slide left, slide right
const int SHOW_STEP_MS = 280;
const int SHOW_SCALE = 65;

void startShow(ShowMove m) {
  stopMotors();
  showMove = m;
  showStep = 0;
  showNextMs = 0;
  Serial.print("BZ:TALK:");
  Serial.println(m == SHOW_HELLO ? 0 : 2);   // "hello" / "happy", on her buzzer
}

void showTick() {
  if ((long)(millis() - showNextMs) < 0) return;
  const bool hello = showMove == SHOW_HELLO;
  if (showStep >= (hello ? SHOW_HELLO_STEPS : SHOW_DANCE_STEPS)) {
    stopMotors();
    return;
  }
  showNextMs = millis() + SHOW_STEP_MS;
  const int beat = hello ? (showStep % 2) + 2 : showStep % 4;
  showStep++;
  // the moves check the walls themselves: blocked, they stop her, and that ends the show
  if (beat == 0) turnLeft(SHOW_SCALE);
  else if (beat == 1) turnRight(SHOW_SCALE);
  else if (beat == 2) strafeLeft(SHOW_SCALE);
  else strafeRight(SHOW_SCALE);
}

// =====================
// IR REMOTE COMMANDS
// =====================
// Driving (D-pad + Enter) only takes effect in MODE_IR — in every other
// mode those buttons are inert so they can't fight the website/BT driver
// or the autonomous/line logic. Mode switching, music, and volume/mute
// always work no matter which drive mode is active.
// Sends one IDA link frame. The receiver is paused while it goes out, and
// any reflection that still sneaks in is dropped in handleIR().
void linkSend(uint16_t address, uint8_t command) {
  IrReceiver.stop();
  IrSender.sendSamsung(address, command, 0);
  IrReceiver.start();
}

void idaSend(uint8_t command) {
  linkSend(IDA_LINK_ADDRESS, command);
}

// Link robot by name or BT letter -> its address, 0 if unknown.
uint16_t linkAddress(String r) {
  r.toLowerCase();
  if (r == "ida" || r == "i") return IDA_LINK_ADDRESS;
  if (r == "mila" || r == "m") return MILA_LINK_ADDRESS;
  if (r == "whip" || r == "w") return WHIP_LINK_ADDRESS;
  if (r == "kida" || r == "k") return KIDA_LINK_ADDRESS;
  if (r == "nika" || r == "n") return NIKA_LINK_ADDRESS;
  return 0;
}

bool isLinkAddress(uint16_t a) {
  return a >= IDA_LINK_ADDRESS && a <= NIKA_LINK_ADDRESS;
}

void sendAvatar(const uint8_t* jpg, size_t len) {
  server.client().setNoDelay(true);  // same slow-send fix as handleRoot()
  server.sendHeader("Cache-Control", "max-age=86400");
  server.send_P(200, "image/jpeg", (PGM_P)jpg, len);
}

// Link command by name, as used by /ida?c=... and the BT 'I' prefix.
// Returns false for an unknown name.
bool idaCommand(const String& c) {
  return linkCommand(IDA_LINK_ADDRESS, c);
}

// Link command by name or BT letter, sent to the robot at address.
bool linkCommand(uint16_t address, const String& c) {
  uint8_t code;
  if (c == "fw" || c == "F") code = LINK_FORWARD;
  else if (c == "bw" || c == "B") code = LINK_BACKWARD;
  else if (c == "left" || c == "L") code = LINK_LEFT;
  else if (c == "right" || c == "R") code = LINK_RIGHT;
  else if (c == "stop" || c == "S") code = LINK_STOP;
  else if (c == "auto" || c == "O") code = LINK_OBSTACLE;
  else if (c == "manual" || c == "W") code = LINK_MANUAL;
  else if (c == "speed" || c == "X") code = LINK_SPEED;
  else if (c == "unlock" || c == "U") code = LINK_UNLOCK;
  else if (c == "lock" || c == "K") code = LINK_LOCK;
  else return false;
  linkSend(address, code);
  lastLinkDriveMs = millis();
  return true;
}

const char* linkName(uint16_t address) {
  switch (address) {
    case IDA_LINK_ADDRESS: return "IDA";
    case MILA_LINK_ADDRESS: return "MILA";
    case WHIP_LINK_ADDRESS: return "WHIP";
    case KIDA_LINK_ADDRESS: return "KIDA";
    case NIKA_LINK_ADDRESS: return "NIKA";
  }
  return "?";
}

// How long saying utterance u takes (ms), symbol by symbol.
unsigned long talkDurationMs(uint8_t u) {
  unsigned long ms = 0;
  for (uint16_t n = 0;; n++) {
    char c = talkSymbol(u, n);
    if (!c) break;
    ms += bfToneMs(c) + TALK_GAP_MS;
  }
  return ms;
}

// Say phrase (0-6) to the robot at address: beep it now, send it over IR
// once she's finished (so the answer doesn't talk over her), log it.
void talkSay(uint16_t address, uint8_t phrase) {
  if (phrase > 6) return;
  Serial.print("BZ:TALK:");
  Serial.println(phrase);
  pendingLinkAddr = address;
  pendingLinkCode = TALK_FIRST + phrase;
  pendingLinkAt = millis() + talkDurationMs(phrase) + 150;
  talkLogMs[talkLogNext] = millis();
  talkLogTo[talkLogNext] = address;
  talkLogPhrase[talkLogNext] = phrase;
  talkLogNext = (talkLogNext + 1) % TALK_LOG_LEN;
  if (talkLogCount < TALK_LOG_LEN) talkLogCount++;
}

// Phrase by name ("hello", "play"...) or number, -1 if unknown.
int talkPhrase(String p) {
  p.toLowerCase();
  for (int i = 0; i < 7; i++)
    if (p == TALK_NAMES[i]) return i;
  if (p == "how") return 1;
  if (p.length() == 1 && isDigit(p[0]) && p[0] <= '6') return p[0] - '0';
  return -1;
}

// Called every loop: chat now and then, and keep the beacon going.
void talkTick(unsigned long now) {
  if (pendingLinkAddr && now >= pendingLinkAt) {
    linkSend(pendingLinkAddr, pendingLinkCode);
    pendingLinkAddr = 0;
    nextBeaconMs = now + 5000;  // leave room for the answer
  }
  if (pendingLinkAddr) return;
  if (now - lastLinkDriveMs < TALK_QUIET_MS) return;  // busy driving someone
  if (irLastDriveMs != 0) return;                     // being driven by the IR remote: keep the receiver free
  if (now >= nextTalkMs && !chatOff) {   // chat off: no chats of her own (the beacon goes on)
    // mostly greetings and good moods; "bye" and "sleepy" now and then
    static const uint8_t PICK[] = { 0, 0, 1, 1, 2, 2, 3, 3, 5, 5, 4, 6 };
    talkSay(IDA_LINK_ADDRESS, PICK[random(sizeof(PICK))]);
    nextTalkMs = now + random(30000, 90000);
    return;
  }
  if (now >= nextBeaconMs) {
    static const uint16_t ROBOTS[] = { IDA_LINK_ADDRESS, MILA_LINK_ADDRESS, WHIP_LINK_ADDRESS, KIDA_LINK_ADDRESS, NIKA_LINK_ADDRESS };
    linkSend(ROBOTS[beaconIndex], TALK_BEACON);
    beaconIndex = (beaconIndex + 1) % 5;
    nextBeaconMs = now + BEACON_EVERY_MS;
  }
}

// Utterance u's Brainfuck program, as a String.
String talkProgram(uint8_t u) {
  String bf;
  for (uint16_t n = 0;; n++) {
    char c = talkSymbol(u, n);
    if (!c) break;
    bf += c;
  }
  return bf;
}

// /talk as JSON, oldest first: {"now":ms,"log":[{"ms":..,"from":"NORA","to":"IDA",
// "said":"hello","text":"hi","bf":"++++++++[>+++++++++++++<-]>.+."},..]}
String talkJson() {
  String j = "{\"now\":" + String(millis()) + ",\"log\":[";
  for (int i = 0; i < talkLogCount; i++) {
    int k = (talkLogNext - talkLogCount + i + TALK_LOG_LEN) % TALK_LOG_LEN;
    if (i) j += ",";
    j += "{\"ms\":" + String(talkLogMs[k]) + ",\"from\":\"NORA\",\"to\":\"" + linkName(talkLogTo[k]) + "\",\"said\":\"" + TALK_NAMES[talkLogPhrase[k]] + "\",\"text\":\"" + TALK_TEXT[talkLogPhrase[k]] + "\",\"bf\":\"" + talkProgram(talkLogPhrase[k]) + "\"}";
  }
  return j + "],\"talk_muted\":" + (talkMuted ? "true" : "false") + ",\"chat_off\":" + (chatOff ? "true" : "false") + "}";
}

// Her two talk switches, as /talkmute answers
String talkSwitchJson() {
  return String("{\"talk_muted\":") + (talkMuted ? "true" : "false") + ",\"chat_off\":" + (chatOff ? "true" : "false") + "}";
}

void handleIR() {
  if (!IrReceiver.decode()) return;

  irFrames++;   // everything heard, obeyed or not
  irLastProto = String(getProtocolString(IrReceiver.decodedIRData.protocol));
  irLastAddr  = IrReceiver.decodedIRData.address;
  irLastCmd   = IrReceiver.decodedIRData.command;

  // our own link frames (a reflection off a nearby wall) aren't commands for NORA
  if (IrReceiver.decodedIRData.protocol == SAMSUNG && isLinkAddress(IrReceiver.decodedIRData.address)) {
    IrReceiver.resume();
    return;
  }

  // Only NORA's own remote (NEC, address 0x00 -- see ir_mapping.txt) is
  // obeyed. IRremote also turns noise into made-up frames of other protocols,
  // and those could land on 1-4 and switch her mode with nobody pressing
  // anything.
  if (IrReceiver.decodedIRData.protocol == NEC && IrReceiver.decodedIRData.address == 0x00) {
    bool isRepeat = IrReceiver.decodedIRData.flags & IRDATA_FLAGS_IS_REPEAT;
    uint8_t cmd = IrReceiver.decodedIRData.command;

    switch (cmd) {
      // ---- driving: IR remote mode only. Repeats (button held) keep it
      // moving; the timeout watchdog in loop() stops it on release. ----
      case IR_UP:
        if (driveMode == MODE_IR) {
          moveForward();
          irLastDriveMs = millis();
        }
        break;
      case IR_DOWN:
        if (driveMode == MODE_IR) {
          moveBackward();
          irLastDriveMs = millis();
        }
        break;
      case IR_LEFT:
        if (driveMode == MODE_IR) {
          irStrafe ? strafeLeft() : turnLeft();
          irLastDriveMs = millis();
        }
        break;
      case IR_RIGHT:
        if (driveMode == MODE_IR) {
          irStrafe ? strafeRight() : turnRight();
          irLastDriveMs = millis();
        }
        break;

      default:
        if (isRepeat) break;  // everything below only fires on the initial press

        switch (cmd) {
          case IR_ENTER:
            if (driveMode == MODE_IR) irStrafe = !irStrafe;
            break;

          // ---- modes (always allowed) ----
          case IR_1:
            setDriveMode(MODE_MANUAL, "ir");
            break;
          case IR_2:
            setDriveMode(MODE_AUTO, "ir");
            break;
          case IR_3:
            setDriveMode(MODE_LINE, "ir");
            break;
          case IR_4:
            setDriveMode(MODE_IR, "ir");
            break;

          // ---- the wheel lock: 5 frees her wheels, 5 again locks them (always allowed) ----
          case IR_5:
            motorLocked = !motorLocked;
            if (motorLocked) stopMotors();
            notifyLock();
            break;

          // ---- speed: 6 slower, 7 faster, 10 % a press (always allowed; like Bluetooth's - / +) ----
          case IR_6:
            speedPct = constrain(speedPct - 10, 10, 100);
            notifySpeed();
            break;
          case IR_7:
            speedPct = constrain(speedPct + 10, 10, 100);
            notifySpeed();
            break;

          // ---- music, forwarded to the Arduino (always allowed) ----
          case IR_PLAY_PAUSE: Serial.println("M:PLAY"); break;
          case IR_STOP: Serial.println("M:STOP"); break;
          case IR_NEXT: Serial.println("M:NEXT"); break;
          case IR_PREV: Serial.println("M:PREV"); break;
          case IR_FFWD: Serial.println("M:NEXT"); break;  // no seek hardware — treat as skip
          case IR_REWIND: Serial.println("M:PREV"); break;
          case IR_REPEAT: Serial.println("M:REPEAT"); break;

          // ---- volume, forwarded to the Arduino (always allowed) ----
          case IR_VOL_UP: Serial.println("V:UP"); break;
          case IR_VOL_DOWN: Serial.println("V:DOWN"); break;
          case IR_MUTE: Serial.println("V:MUTE"); break;
        }
        break;
    }
  }

  IrReceiver.resume();
}

// =====================
// READ ARDUINO SERIAL
// =====================
void readSerialSensors() {
  while (Serial.available()) {
    char c = Serial.read();
    if (c == '\n') {
      parseSensorLine(serialBuffer);
      serialBuffer = "";
    } else if (c != '\r') {
      serialBuffer += c;
    }
  }
}

void parseSensorLine(String line) {
  // The fleet-wide handshake: a PC on her USB port asking "WHO". (The UNO
  // hears the reply too and ignores it.)
  if (line == "WHO") {
    Serial.println("I am Nora");
    return;
  }
  // Only the UNO's status lines carry readings; anything else would zero them.
  if (!line.startsWith("F:")) return;
  auto extractFloat = [&](String key) -> float {
    int idx = line.indexOf(key + ":");
    if (idx == -1) return -1;
    int start = idx + key.length() + 1;
    int end = line.indexOf(',', start);
    String val = (end == -1) ? line.substring(start) : line.substring(start, end);
    return val.toFloat();
  };

  front_cm = extractFloat("F");
  left_cm = extractFloat("L");
  back_cm = extractFloat("B");
  right_cm = extractFloat("R");

  float mt = extractFloat("MT");
  float ms = extractFloat("MS");
  if (mt >= 0) musicTrack = (int)mt;
  if (ms >= 0) musicState = (int)ms;

  float lt = extractFloat("LT");
  if (lt >= 0) lightPct = (int)lt;
  float sd = extractFloat("SD"), nt = extractFloat("NT");
  if (sd >= 0) sdOk = (int)sd;
  if (nt >= 0) sdTracks = (int)nt;

  // ---- Sound event: edge-detected + debounced on the Arduino already,
  // we just run the clap-count timing off of this latched flag.
  // 1 clap  -> play music  (fired from loop() once the window times out
  //            with no second clap -- see there for why)
  // 2 claps within 0.8s -> stop music (fires immediately, no need to wait:
  //            seeing the 2nd clap already confirms it wasn't a single)
  //
  // Ignored for the first CLAP_BOOT_GRACE_MS after boot: the Arduino's
  // startup chime (track000.mp3) plays right into the same board's sound
  // sensor, which reads its own speaker as a "clap" and would otherwise
  // fire M:PLAY the moment the chime ends -- music starting on its own
  // right after the boot sound, with nobody actually clapping. ----
  if (millis() < CLAP_BOOT_GRACE_MS) return;
  if (extractFloat("SND") == 1) {
    unsigned long now = millis();
    lastSoundMs = now;
    if (clapCount == 0 || now - firstClapMs > 800) {
      clapCount = 1;
      firstClapMs = now;
    } else {
      clapCount++;
    }
    if (clapCount >= 2) {
      Serial.println("M:STOP");
      clapCount = 0;
    }
  }
}

// =====================
// LINE FOLLOWER MODE
// =====================
// Same shape of fix as AutonomousMode(): gentler turns instead of full-speed
// pivots (less zigzag along the line), and a fail-safe stop instead of
// spinning in place forever once the line is genuinely lost.
void LineFollowerMode(int l, int m, int r) {
  const int TURN_SCALE = 65;           // gentler than a full-speed pivot
  const unsigned long LOST_MS = 1000;  // give up and stop after this long off-line

  // A line can run straight into a wall, and a dark floor reads as "line"
  // on all three sensors -- so wait here rather than drive into it.
  if (front_cm > 0 && front_cm < MANUAL_STOP_CM) {
    stopMotors();
    return;
  }
  // Another robot very close with right of way: wait on the line (no turning off it).
  if (fleetGiveWay(false) != FLEET_GO) {
    stopMotors();
    return;
  }

  int pattern = (l << 2) | (m << 1) | r;
  switch (pattern) {
    case 0b010:
    case 0b111:
    case 0b101:  // both outer sensors on line, middle off — wide line/intersection, keep going
      lineLostSinceMs = 0;
      moveForward();
      break;
    case 0b110:
    case 0b100:
      lineLastTurn = -1;
      lineLostSinceMs = 0;
      turnLeft(TURN_SCALE);
      break;
    case 0b011:
    case 0b001:
      lineLastTurn = 1;
      lineLostSinceMs = 0;
      turnRight(TURN_SCALE);
      break;
    case 0b000:
      if (lineLostSinceMs == 0) lineLostSinceMs = millis();
      if (millis() - lineLostSinceMs > LOST_MS) stopMotors();
      else if (lineLastTurn < 0) turnLeft(TURN_SCALE);
      else turnRight(TURN_SCALE);
      break;
    default: moveForward(); break;
  }
}

// =====================
// AUTONOMOUS MODE
// =====================
void moveDir(int dir, int scale) {
  switch (dir) {
    case DIR_FRONT: moveForward(scale); break;
    case DIR_RIGHT: strafeRight(scale); break;
    case DIR_BACK: moveBackward(scale); break;
    case DIR_LEFT: strafeLeft(scale); break;
  }
}

// Auto mode: drive `dir` at `scale` %, sliding away from a wall beside her (the two sensors across
// her way), so the sides stop scraping. Further than SIDE_CM: straight on. Closer: she slides
// away the more, the closer it is; under SIDE_CRITICAL_CM she stops going on and only slides away.
// Mecanum wheels can do both at once (driveMix).
const float SIDE_CM = 20.0;
const float SIDE_CRITICAL_CM = 9.0;
void moveDirAway(int dir, int scale, const float dist[4]) {
  const int a = (dir + 1) % 4, b = (dir + 3) % 4;   // the sensors either side of her way
  const float da = dist[a], db = dist[b], near = min(da, db);
  if (near >= SIDE_CM) { moveDir(dir, scale); return; }
  // along: front +f, back -f, left +s, right -s
  static const float F[4] = { 1, 0, -1, 0 }, S[4] = { 0, -1, 0, 1 };
  const float push = (SIDE_CM - near) / (SIDE_CM - SIDE_CRITICAL_CM);   // 0 at SIDE_CM, 1 at critical
  const float go = near < SIDE_CRITICAL_CM ? 0 : scale / 100.0f;
  const float away = 0.6f * min(push, 1.0f);
  const int from = da < db ? a : b;                  // slide away from the nearer wall
  driveMix(go * F[dir] - away * F[from], go * S[dir] - away * S[from], 0);
}

int clearestDir(float dist[4]) {
  int best = 0;
  for (int d = 1; d < 4; d++)
    if (dist[d] > dist[best]) best = d;
  return best;
}

// Reactive omnidirectional avoidance. Beyond the original bang-bang
// controller, this adds:
//   - EMA smoothing per sensor so single noisy pings don't flip decisions
//   - cautious (not "infinite") handling of dropped/out-of-range readings,
//     since a failed echo can mean "too close" just as easily as "clear"
//   - a switch hysteresis margin so it won't flap between two directions
//     that read almost the same distance
//   - a slow-down band instead of full speed all the way to CRITICAL
//   - an escape turn when genuinely boxed in, instead of freezing forever
void AutonomousMode(float front, float left, float back, float right) {
  // Another robot close by (fleet_near.h): give way if it has right of way,
  // and drive slower with wider margins while one is near.
  FleetYieldPhase yieldNow = fleetGiveWay(true);
  if (yieldNow == FLEET_WAIT) {
    stopMotors();
    return;
  }
  if (yieldNow == FLEET_TURN) {
    turnLeft(60);
    return;
  }
  const bool caution = fleetNearAdvice() != FLEET_CLEAR;
  // she ran into walls at 15 / 28 (2026-10-28): stop sooner, slow down sooner
  const float DANGER = caution ? 50.0 : 40.0;
  const float CRITICAL = caution ? 30.0 : 22.0;
  const int CRUISE = caution ? 60 : 100;   // % speed when the way is clear
  const float SWITCH_MARGIN = 8.0;  // new dir must clear the old one by this much
  const float UNKNOWN_CM = 45.0;    // cautious guess once a sensor goes stale (just past DANGER)
  const int CREEP_SCALE = 55;       // % speed while inside the DANGER band
  const unsigned long STALE_MS = 800;
  const unsigned long STUCK_MS = 1200;
  const unsigned long ESCAPE_MS = 400;

  unsigned long now = millis();

  // ---- per-sensor smoothing with cautious dropout handling ----
  static float filtered[4] = { UNKNOWN_CM, UNKNOWN_CM, UNKNOWN_CM, UNKNOWN_CM };
  static unsigned long lastGoodMs[4] = { 0, 0, 0, 0 };
  float raw[4] = { front, right, back, left };  // matches DIR_FRONT/RIGHT/BACK/LEFT

  for (int d = 0; d < 4; d++) {
    if (raw[d] > 0) {
      filtered[d] = (lastGoodMs[d] == 0) ? raw[d] : (filtered[d] * 0.5 + raw[d] * 0.5);
      lastGoodMs[d] = now;
    } else if (now - lastGoodMs[d] > STALE_MS) {
      // no valid echo in a while: could be "clear" or could be "too close to
      // hear the echo" — assume neither, treat it as merely borderline
      filtered[d] = UNKNOWN_CM;
    }
    // else: a brief dropout — keep trusting the last smoothed value
  }
  float dist[4] = { filtered[0], filtered[1], filtered[2], filtered[3] };

  // ---- boxed-in escape: turn toward the more open side instead of freezing ----
  if (autoEscaping) {
    if (now < autoEscapeUntilMs) return;
    autoEscaping = false;
    stopMotors();
    autoState = AUTO_COOLDOWN;
    autoCooldown = now + 150;
    autoStuckSinceMs = 0;
    return;
  }

  if (autoState == AUTO_COOLDOWN) {
    if (now < autoCooldown) return;
    int best = clearestDir(dist);
    if (dist[best] < DANGER) {
      if (autoStuckSinceMs == 0) autoStuckSinceMs = now;
      if (now - autoStuckSinceMs > STUCK_MS) {
        if (dist[DIR_LEFT] >= dist[DIR_RIGHT]) turnLeft(CREEP_SCALE);
        else turnRight(CREEP_SCALE);
        autoEscaping = true;
        autoEscapeUntilMs = now + ESCAPE_MS;
        return;
      }
      autoCooldown = now + 300;
      return;
    }
    autoStuckSinceMs = 0;
    autoDir = best;
    moveDirAway(autoDir, CRUISE, dist);
    autoState = AUTO_MOVING;
    return;
  }

  // AUTO_MOVING
  float cur = dist[autoDir];
  if (cur < CRITICAL) {
    stopMotors();
    autoState = AUTO_COOLDOWN;
    autoCooldown = now + 250;
  } else if (cur < DANGER) {
    int best = clearestDir(dist);
    if (best != autoDir && dist[best] > dist[autoDir] + SWITCH_MARGIN && dist[best] > DANGER) {
      stopMotors();
      autoDir = best;
      moveDirAway(autoDir, CRUISE, dist);
      autoState = AUTO_COOLDOWN;
      autoCooldown = now + 150;
    } else {
      moveDirAway(autoDir, CREEP_SCALE, dist);  // getting close — creep instead of full speed
    }
  } else {
    moveDirAway(autoDir, CRUISE, dist);  // clear again — resume cruising speed
  }
}

// =====================
// FLEET REGISTRY LOGIC
// =====================
void fleetPrune() {
  unsigned long now = millis();
  for (int i = 0; i < FLEET_MAX; i++) {
    if (fleet[i].used && now - fleet[i].lastSeenMs > FLEET_TTL_MS) fleet[i].used = false;
  }
  if (authorityExpiresMs != 0 && now > authorityExpiresMs) {
    authorityName = "NORA";  // authority's heartbeat lapsed — reclaim the role
    authorityExpiresMs = 0;
  }
}

void fleetRegister(const String& name, const String& type, const String& caps, IPAddress ip) {
  unsigned long now = millis();
  int slot = -1;
  for (int i = 0; i < FLEET_MAX; i++) {
    if (fleet[i].used && fleet[i].name == name) {
      slot = i;
      break;
    }  // re-register = heartbeat
  }
  if (slot == -1) {
    for (int i = 0; i < FLEET_MAX; i++)
      if (!fleet[i].used) {
        slot = i;
        break;
      }
  }
  if (slot == -1) return;  // registry full — stale entries free up via TTL on their own

  fleet[slot].used = true;
  fleet[slot].name = name;
  fleet[slot].type = type;
  fleet[slot].capabilities = caps;
  fleet[slot].ip = ip;
  fleet[slot].lastSeenMs = now;

  if (type == "fleet_manager") {
    authorityName = name;
    authorityExpiresMs = now + FLEET_TTL_MS;
  }
}

// "a, b,c" -> ["a","b","c"]
String fleetCapsToJsonArray(const String& caps) {
  String out = "[";
  int start = 0;
  bool first = true;
  while (start <= (int)caps.length()) {
    int comma = caps.indexOf(',', start);
    String item = (comma == -1) ? caps.substring(start) : caps.substring(start, comma);
    item.trim();
    if (item.length()) {
      if (!first) out += ",";
      out += "\"" + item + "\"";
      first = false;
    }
    if (comma == -1) break;
    start = comma + 1;
  }
  out += "]";
  return out;
}

// ---- The fleet's network --------------------------------------------------
IPAddress myIP() { return onRift ? WiFi.localIP() : WiFi.softAPIP(); }

// Index in ABOVE_NORA of the highest of those networks in the last scan, or -1.
int bestAbove(int n) {
  int best = -1;
  for (int i = 0; i < n; i++)
    for (int r = 0; r < (int)(sizeof(ABOVE_NORA) / sizeof(ABOVE_NORA[0])); r++)
      if (WiFi.SSID(i) == ABOVE_NORA[r] && (best < 0 || r < best)) best = r;
  return best;
}

void setupWiFi() {
  WiFi.mode(WIFI_STA);
  WiFi.setAutoReconnect(true);
  int n = WiFi.scanNetworks();
  int rank = bestAbove(n);
  WiFi.scanDelete();
  if (rank < 0) rank = 0;   // nothing seen: still give RIFT a try (it may be slow to show up)
  for (; rank < (int)(sizeof(ABOVE_NORA) / sizeof(ABOVE_NORA[0])); rank++) {
    WiFi.begin(ABOVE_NORA[rank], FLEET_PASSWORD);
    unsigned long start = millis();
    while (WiFi.status() != WL_CONNECTED && millis() - start < FLEET_JOIN_MS) delay(250);
    if (WiFi.status() == WL_CONNECTED) {
      onRift = true;
      joinedRank = rank;
      fleetNearBegin("NORA", WIFI_IF_STA);
      return;
    }
    WiFi.disconnect(false);
  }
  WiFi.disconnect(false);
  WiFi.setAutoReconnect(false);
  WiFi.mode(WIFI_AP_STA);   // AP for the robots; STA only so she can scan for RIFT
  WiFi.softAP(ap_ssid, ap_password, 1, 0, 8);   // channel 1, visible, up to 8 robots (the default is 4)
  onRift = false;
  fleetNearBegin("NORA", WIFI_IF_AP);   // she hosts the network, so ESP-NOW rides on her AP's channel
}

// On a network above her: tell its fleet list she's here, like every other robot,
// and on a lower one keep an eye out for a higher one. On her own: look for either now and then.
// Moving up is a restart, only while she's parked.
void fleetNetworkLoop() {
  static unsigned long lastMs = 0;
  static unsigned long lastScanMs = 0;
  if (onRift && joinedRank > 0 && millis() - lastScanMs > 2 * RIFT_SCAN_MS) {   // not on RIFT: is a higher one back?
    lastScanMs = millis();
    int n = WiFi.scanComplete();
    if (n == WIFI_SCAN_FAILED) WiFi.scanNetworks(true);
    else if (n >= 0) {
      int best = bestAbove(n);
      WiFi.scanDelete();
      if (best >= 0 && best < joinedRank && !motorsMoving && driveMode != MODE_AUTO && driveMode != MODE_LINE) ESP.restart();
    }
  }
  if (onRift) {
    // Still connected? Is the host still answering? Every heartbeat tells: no WiFi, or no fleet list
    // that takes her /register, for NET_LOST_MS and she starts over (a restart: climb, else host).
    static unsigned long goneSince = 0;
    bool up = WiFi.status() == WL_CONNECTED;
    if (!up && !goneSince) goneSince = millis();
    if (goneSince && millis() - goneSince > NET_LOST_MS
        && !motorsMoving && driveMode != MODE_AUTO && driveMode != MODE_LINE) ESP.restart();
    if (millis() - lastMs < RIFT_REGISTER_MS || !up) return;
    lastMs = millis();
    HTTPClient http;
    http.setTimeout(1500);
    http.begin(String("http://") + WiFi.gatewayIP().toString() + ":" + RIFT_PORT + "/register");   // whoever hosts
    http.addHeader("Content-Type", "application/x-www-form-urlencoded");
    int code = http.POST("name=NORA&type=omni&capabilities=obstacle_avoidance,line_follow,uv_light,music,ir_link,web:5002,talk:5002");
    http.end();
    if (code == 200) goneSince = 0;
    else if (!goneSince) goneSince = millis();
    return;
  }
  if (millis() - lastMs < RIFT_SCAN_MS) return;
  lastMs = millis();
  int n = WiFi.scanComplete();
  if (n == WIFI_SCAN_FAILED) { WiFi.scanNetworks(true); return; }   // start one; read it next time
  if (n < 0) return;                                                // still scanning
  bool seen = bestAbove(n) >= 0;
  WiFi.scanDelete();
  if (seen && !motorsMoving && driveMode != MODE_AUTO && driveMode != MODE_LINE) ESP.restart();
}

void setupFleetServer() {
  fleetServer.on("/ping", []() {
    fleetServer.send(200, "text/plain", "NORA alive");
  });

  fleetServer.on("/register", HTTP_POST, []() {
    String name = fleetServer.hasArg("name") ? fleetServer.arg("name") : "";
    String type = fleetServer.hasArg("type") ? fleetServer.arg("type") : "unknown";
    String caps = fleetServer.hasArg("capabilities") ? fleetServer.arg("capabilities") : "";
    if (name.length() == 0) {
      fleetServer.send(400, "text/plain", "missing 'name'");
      return;
    }
    fleetRegister(name, type, caps, fleetServer.client().remoteIP());
    fleetServer.send(200, "text/plain", "OK");
  });

  fleetServer.on("/robots", HTTP_GET, []() {
    fleetPrune();

    String json = "{\"authority\":\"" + authorityName + "\",\"robots\":[";
    json += "{\"name\":\"NORA\",\"type\":\"omni\",\"ip\":\"" + myIP().toString() + "\",\"capabilities\":[\"obstacle_avoidance\",\"line_follow\",\"uv_light\",\"music\"]}";

    // While someone else is the live authority, don't also author a
    // competing roster — just point callers at her. Entries registered
    // during that time are still tracked quietly so there's no gap the
    // instant NORA reclaims the role.
    if (authorityExpiresMs == 0) {
      for (int i = 0; i < FLEET_MAX; i++) {
        if (!fleet[i].used) continue;
        // "0.0.0.0" here means this entry heartbeated over Bluetooth (the
        // 'H' command above), not WiFi, so there's no real IP to report.
        json += ",{\"name\":\"" + fleet[i].name + "\",\"type\":\"" + fleet[i].type + "\",\"ip\":\"" + fleet[i].ip.toString() + "\",\"capabilities\":" + fleetCapsToJsonArray(fleet[i].capabilities) + "}";
      }
    }

    json += "]}";
    fleetServer.send(200, "application/json", json);
  });

  fleetServer.begin();
}

// =====================
// WEB PAGE (stored in flash, not RAM)
// =====================
static const char INDEX_HTML[] PROGMEM = R"rawhtml(
<!DOCTYPE html>
<html>
<head>
  <meta name="viewport" content="width=device-width, initial-scale=1, user-scalable=no">
  <title>NORA Control</title>
  <link rel="icon" href="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">
  <style>
    :root {
      /* colour_scheme.xml, as her Python controller */
      --bg:      #090B11;
      --panel:   #0F141E;
      --border:  #1F273D;
      --accent:  #F7BF28;
      --accent-rgb: 247,191,40;
      --text:    #F2EFE9;
      --text-sec:#A8A394;
      --text-dim:#6B6557;
      --red:     #D34E41;
      --red-rgb: 211,78,65;
      --hover:   #251F0E;
      --radius:  6px;
      --font:    'Courier New', Courier, monospace;
    }
    * { box-sizing: border-box; margin: 0; padding: 0; }
    body { background: var(--bg); color: var(--text-sec); font-family: var(--font); font-size: 15px; min-height: 100vh; padding: 12px; }
    button, .btn, .ida-btn, .mode-btn {
      font-family: var(--font); font-weight: bold; color: var(--text-sec); background: var(--panel);
      border: 2px solid var(--border); border-radius: var(--radius); cursor: pointer; user-select: none;
      -webkit-tap-highlight-color: transparent; letter-spacing: 1px;
    }
    #app { display: grid; grid-template-columns: minmax(0, 390px) 216px; gap: 18px; justify-content: center; align-items: start; }
    #left { display: flex; flex-direction: column; gap: 10px; }
    #right { background: var(--panel); border: 2px solid var(--border); border-radius: var(--radius);
             padding: 12px 10px; display: flex; flex-direction: column; align-items: center; gap: 10px; }

    #top { display: grid; grid-template-columns: 56px 1fr auto; gap: 10px; align-items: center; }
    #title { text-align: center; }
    h1 { font-size: 1.5rem; letter-spacing: 1px; color: var(--accent); }
    #status { font-size: 0.8rem; color: var(--accent); }
    .avatar { width: 56px; height: 56px; border-radius: 50%; object-fit: cover; }
    .keys-link { padding: 6px 10px; font-size: 0.75rem; text-decoration: none; }

    #sensors { display: grid; grid-template-columns: 1fr 1fr; gap: 10px; }
    .sensor-box { background: var(--panel); border: 2px solid var(--border); border-radius: var(--radius);
                  padding: 9px 10px 8px; display: flex; flex-direction: column; gap: 8px; color: var(--text); }
    .sensor-top { display: flex; gap: 8px; }
    .sensor-box span { color: var(--text); }
    .sensor-box.warn { border-color: var(--accent); }
    .sensor-box.crit { border-color: var(--red); background: rgba(var(--red-rgb), 0.12); }
    .sensor-box.travel { border-color: var(--accent); background: rgba(var(--accent-rgb), 0.12); }
    .dist-bar-bg { background: var(--border); border-radius: 3px; height: 4px; overflow: hidden; }
    .dist-bar { height: 4px; border-radius: 3px; background: var(--accent); width: 0%; transition: width 0.3s; }

    #lfRow, #envRow { display: flex; gap: 8px; align-items: center; color: var(--text-dim); padding: 2px 2px; }
    #lfRow span, #envRow span { color: var(--text-sec); }
    .lf-dot { width: 20px; height: 20px; border-radius: 50%; background: var(--panel); border: 2px solid var(--border); }
    .lf-dot.on { background: var(--accent); border-color: var(--accent); }

    #musicTop { display: flex; gap: 22px; color: var(--accent); }
    #musicTrack { color: var(--accent); }
    #musicState { color: var(--text-dim); }
    #musicState.playing { color: var(--text); }
    #musicState.paused { color: var(--accent); }
    #fleetBox { font-size: 0.92rem; color: var(--text); line-height: 1.35; min-height: 3.6em; }
    #fleetBox b { color: var(--accent); font-weight: normal; }

    #lockBtn { width: 100%; padding: 9px; font-size: 0.9rem; }
    #lockBtn.locked { border-color: var(--accent); color: var(--accent); background: var(--hover); }
    #lockBtn.unlocked { border-color: var(--border); color: var(--text-sec); }

    #modeRow { display: grid; grid-template-columns: repeat(4, 1fr); gap: 8px; }
    #btnStay { grid-column: span 4; }
    .mode-btn { padding: 9px 0; font-size: 0.85rem; text-align: center; }
    .mode-btn.active { border-color: var(--accent); color: var(--accent); background: var(--hover); }
    #actRow { display: grid; grid-template-columns: 2fr repeat(4, 1fr); gap: 8px; }
    #uvBtn { padding: 8px 0; font-size: 0.85rem; }
    #uvBtn.on, #uvBtn.blink { border-color: var(--accent); color: var(--accent); background: var(--hover); }
    .mu-btn { padding: 8px 0; font-size: 0.85rem; }
    .mu-btn:active, .mode-btn:active { border-color: var(--accent); color: var(--accent); }
    #showRow { display: grid; grid-template-columns: 1fr 1fr; gap: 8px; }
    #showRow .mode-btn { padding: 5px 0; }

    #speedRow { display: flex; align-items: center; gap: 10px; color: var(--text-dim); }
    #speedRow input[type=range] { flex: 1; accent-color: var(--accent); }
    #speedVal { width: 40px; text-align: right; color: var(--accent); }

    .dpad { display: grid; grid-template-columns: repeat(3, 80px); grid-template-rows: repeat(3, 80px); gap: 8px; justify-content: center; }
    .btn { display: flex; align-items: center; justify-content: center; font-size: 1.05rem; touch-action: none; }
    .btn.disabled { opacity: 0.45; pointer-events: none; }
    .btn.pressed { background: var(--hover); border-color: var(--accent); color: var(--accent); }
    .btn.stop-btn { font-size: 0.85rem; opacity: 1; }
    .fw { grid-column: 2; grid-row: 1; } .turnL { grid-column: 1; grid-row: 2; } .left { grid-column: 1; grid-row: 3; }
    .stop { grid-column: 2; grid-row: 2; } .bw { grid-column: 2; grid-row: 3; } .turnR { grid-column: 3; grid-row: 2; } .right { grid-column: 3; grid-row: 3; }

    /* the link panel: drive another robot through NORA's IR transmitter */
    #right { --link: #D6935A; }
    #linkPick { display: grid; grid-template-columns: 30px 1fr 30px; align-items: center; gap: 6px; width: 100%; }
    #linkPick button { height: 38px; }
    #linkPick .avatar { width: 98px; height: 98px; justify-self: center; }
    #linkName { color: var(--link); font-size: 1.4rem; font-weight: bold; }
    #idaTop { text-align: center; }
    #idaTop small { display: block; color: var(--text-sec); font-size: 0.8rem; margin-top: 4px; }
    #idaStatus { color: var(--text); font-size: 0.8rem; }
    #idaModes { display: grid; grid-template-columns: repeat(6, 1fr); gap: 5px; width: 100%; }
    #idaModes .mode-btn { grid-column: span 3; font-size: 0.75rem; padding: 7px 0; }
    #idaModes .third { grid-column: span 2; font-size: 0.68rem; letter-spacing: 0; }
    .ida-pad { display: grid; grid-template-columns: repeat(3, 58px); grid-template-rows: repeat(3, 58px); gap: 6px; }
    .ida-btn { display: flex; align-items: center; justify-content: center; font-size: 1rem; touch-action: none; background: var(--bg); }
    .ida-btn.pressed { border-color: var(--link); color: var(--link); }
    .ida-btn.istop { font-size: 0.8rem; }
    .ifw { grid-column: 2; grid-row: 1; } .ileft { grid-column: 1; grid-row: 2; } .istop { grid-column: 2; grid-row: 2; }
    .iright { grid-column: 3; grid-row: 2; } .ibw { grid-column: 2; grid-row: 3; }
    #linkKeys { font-size: 0.8rem; text-align: center; line-height: 1.4; color: var(--text-sec); }
    #topView { width: 100%; border: 1px solid var(--border); border-radius: var(--radius); background: var(--bg); }
    #topView text { fill: var(--text-sec); font: 13px var(--font); }
    #topView .axis { stroke: var(--border); stroke-width: 1; }
    #topView .wall { stroke: var(--accent); stroke-width: 3; }
    #talkLog { width: 100%; font-size: 0.72rem; color: var(--text-dim); line-height: 1.5; }
    #talkLog b { color: var(--link); font-weight: normal; }
    #talkLog code { font-size: 0.65rem; word-break: break-all; color: var(--text-sec); }

    #calPanel { background: var(--panel); border: 2px solid var(--border); border-radius: var(--radius); padding: 10px; }
    #calPanel summary { color: var(--accent); cursor: pointer; user-select: none; font-weight: bold; }
    .cal-row { display: flex; align-items: center; gap: 10px; font-size: 0.8rem; margin-top: 8px; }
    .cal-row label { width: 24px; color: var(--text-dim); }
    .cal-row input[type=range] { flex: 1; accent-color: var(--accent); }
    .cal-row span { width: 30px; text-align: right; color: var(--accent); }
    #saveCalBtn { display: block; margin: 10px 0 0 auto; padding: 6px 16px; border: 0; background: var(--accent); color: var(--bg); }
    #saveCalBtn.saved { background: var(--text-dim); }
    #hint { text-align: center; color: var(--text-dim); font-size: 0.8rem; margin-top: 14px; }

    @media (max-width: 630px) { #app { grid-template-columns: minmax(0, 390px); } }
  </style>
</head>
<body>
<div id="app">
<div id="left">
  <div id="top">
    <img class="avatar" src="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" alt="NORA">
    <div id="title"><h1>NORA</h1><div id="status">Idle</div></div>
    <a class="mode-btn keys-link" href="/keys" target="nora_keys">KEYS</a>
  </div>

  <div id="sensors">
    <div class="sensor-box" id="boxF">
      <div class="sensor-top">Front <span><span id="sF">--</span> cm</span></div>
      <div class="dist-bar-bg"><div class="dist-bar" id="barF"></div></div>
    </div>
    <div class="sensor-box" id="boxB">
      <div class="sensor-top">Back <span><span id="sB">--</span> cm</span></div>
      <div class="dist-bar-bg"><div class="dist-bar" id="barB"></div></div>
    </div>
    <div class="sensor-box" id="boxL">
      <div class="sensor-top">Left <span><span id="sL">--</span> cm</span></div>
      <div class="dist-bar-bg"><div class="dist-bar" id="barL"></div></div>
    </div>
    <div class="sensor-box" id="boxR">
      <div class="sensor-top">Right <span><span id="sR">--</span> cm</span></div>
      <div class="dist-bar-bg"><div class="dist-bar" id="barR"></div></div>
    </div>
  </div>

  <div id="lfRow">
    Line:
    <div class="lf-dot" id="lfL"></div>
    <div class="lf-dot" id="lfM"></div>
    <div class="lf-dot" id="lfR"></div>
    &nbsp;&nbsp;Light: <span id="lightVal">--%</span>
    &nbsp;&nbsp;<div class="lf-dot" id="sndDot" title="sound"></div> sound
  </div>

  <div id="envRow">
    Temp: <span id="tempVal">--</span>&deg;C
    &nbsp;&nbsp;Humidity: <span id="humVal">--</span>%
  </div>

  <div id="musicTop">
    <span>MUSIC</span>
    <span id="musicTrack">track---</span>
    <span id="musicState">stopped</span>
  </div>
  <div id="fleetBox"></div>

  <button id="lockBtn" class="locked" onclick="toggleLock()">MOTOR LOCK: ON</button>

  <div id="modeRow">
    <button class="mode-btn active" id="btnManual" onclick="setMode('Manual')">MANUAL</button>
    <button class="mode-btn" id="btnAuto" onclick="setMode('Auto')">AUTO</button>
    <button class="mode-btn" id="btnLine" onclick="setMode('Line')">LINE</button>
    <button class="mode-btn" id="btnFollow" onclick="setMode('Follow')" title="she keeps your hand 30 cm from her front sonar">FOLLOW</button>
    <button class="mode-btn" id="btnStay" onclick="setMode('Stay')" title="she keeps near RITA, in your hand">STAY CLOSE</button>
    <button class="mode-btn" id="btnMind" onclick="setMode('Mind')" style="display:none" title="the LLM on her PC controller drives her">MIND</button>
  </div>

  <div id="actRow">
    <button id="uvBtn" onclick="cycleUV()">UV OFF</button>
    <button class="mu-btn" onclick="cmd('/muPrev')">|&lt;</button>
    <button class="mu-btn" onclick="cmd('/muPlay')">&gt;||</button>
    <button class="mu-btn" onclick="cmd('/muNext')">&gt;|</button>
    <button class="mu-btn" onclick="cmd('/muStop')">[]</button>
  </div>

  <div id="showRow">
    <button class="mode-btn" onclick="cmd('/act?do=hello')" title="a wiggle and a beep, in MANUAL">HELLO</button>
    <button class="mode-btn" onclick="cmd('/act?do=dance')" title="on the spot, in MANUAL">DANCE</button>
  </div>

  <div class="dpad">
    <div class="btn fw" data-cmd="/fw">^</div>
    <div class="btn turnL" data-cmd="/turnL">@&lt;</div>
    <div class="btn stop-btn stop" data-cmd="/stop">STOP</div>
    <div class="btn bw" data-cmd="/bw">v</div>
    <div class="btn left" data-cmd="/left">&lt;</div>
    <div class="btn turnR" data-cmd="/turnR">&gt;@</div>
    <div class="btn right" data-cmd="/right">&gt;</div>
  </div>

  <div id="speedRow">
    Speed
    <input id="speedSlider" type="range" min="0" max="100" value="100" oninput="setSpeed(this)">
    <span id="speedVal">100%</span>
  </div>

  <details id="calPanel">
    <summary>Wheel Calibration</summary>
    <div class="cal-row"><label>M1</label><input id="sl1" type="range" min="0" max="255" value="255" oninput="setCal(this,0,'v1')"><span id="v1">255</span></div>
    <div class="cal-row"><label>M2</label><input id="sl2" type="range" min="0" max="255" value="255" oninput="setCal(this,1,'v2')"><span id="v2">255</span></div>
    <div class="cal-row"><label>M3</label><input id="sl3" type="range" min="0" max="255" value="255" oninput="setCal(this,2,'v3')"><span id="v3">255</span></div>
    <div class="cal-row"><label>M4</label><input id="sl4" type="range" min="0" max="255" value="255" oninput="setCal(this,3,'v4')"><span id="v4">255</span></div>
    <button id="saveCalBtn" onclick="saveCal()">Save</button>
  </details>
</div>

<div id="right">
  <div id="linkPick">
    <button onclick="stepRobot(-1)" aria-label="previous robot">&lt;</button>
    <img class="avatar" id="linkAvatar" src="/avatar/ida.jpg" alt="IDA">
    <button onclick="stepRobot(1)" aria-label="next robot">&gt;</button>
  </div>
  <div id="idaTop">
    <b id="linkName">IDA</b>
    <small>via NORA's IR link</small>
  </div>
  <div id="idaStatus">ready</div>
  <div id="idaModes">
    <button class="mode-btn" onclick="ida('manual')">MANUAL</button>
    <button class="mode-btn" onclick="ida('auto')">AUTO</button>
    <button class="mode-btn third" onclick="ida('speed')">SPEED</button>
    <button class="mode-btn third" onclick="ida('unlock')" title="free the wheels of this robot">UNLOCK</button>
    <button class="mode-btn third" onclick="ida('lock')" title="lock the wheels of this robot">LOCK</button>
  </div>
  <div class="ida-pad">
    <div class="ida-btn ifw" data-ida="fw">^</div>
    <div class="ida-btn ileft" data-ida="left">&lt;</div>
    <div class="ida-btn istop" data-ida="stop">STOP</div>
    <div class="ida-btn iright" data-ida="right">&gt;</div>
    <div class="ida-btn ibw" data-ida="bw">v</div>
  </div>
  <div id="linkKeys">I J K L drive<br>Tab robot &middot; <a href="#" onclick="sayHi();return false" style="color:inherit">say hi</a> &middot; <a href="#" id="talkMuteBtn" onclick="talkSwitch('on');return false" style="color:inherit" title="Sound: she chats, but the buzzer stays quiet">sound on</a> &middot; <a href="#" id="chatBtn" onclick="talkSwitch('chat_off');return false" style="color:inherit" title="Chat: in or out of the fleet&rsquo;s conversations">chat on</a></div>
  <svg id="topView" viewBox="0 0 200 220">
    <text x="8" y="17">from above</text>
    <line class="axis" x1="100" y1="24" x2="100" y2="216"/><line class="axis" x1="10" y1="120" x2="190" y2="120"/>
    <line class="wall" id="wallF"/><line class="wall" id="wallB"/><line class="wall" id="wallL"/><line class="wall" id="wallR"/>
    <rect x="72" y="92" width="10" height="16" rx="2" fill="#6B6557"/><rect x="118" y="92" width="10" height="16" rx="2" fill="#6B6557"/>
    <rect x="72" y="132" width="10" height="16" rx="2" fill="#6B6557"/><rect x="118" y="132" width="10" height="16" rx="2" fill="#6B6557"/>
    <rect x="82" y="96" width="36" height="48" rx="4" fill="#1F273D"/>
    <polygon points="100,100 106,110 94,110" fill="#F7BF28"/>
  </svg>
  <div id="talkLog"></div>
</div>
</div>
<div id="hint">WASD drive &middot; Q/E turn &middot; space play &middot; M next &middot; X speed &middot; U uv &middot; 1-4 mode</div>

<script>
  let activeCmd = null, cmdInterval = null;
  const calVals  = [255,255,255,255];
  let calTimer   = null;
  let speedTimer = null;
  let uvState    = 0;
  let currentMode = 'Manual';
  let motorLocked = true;   // matches firmware's boot-time default

  const dirBox = ['boxF', 'boxR', 'boxB', 'boxL'];

  function cmd(c) { fetch(c).catch(() => {}); }

  const modeNames = ['Manual', 'Auto', 'Line', 'IR', 'Mind', 'Follow', 'Stay'];

  // Applies a mode to the UI only -- used both when we initiate a change
  // (setMode) and when we're just reflecting one that happened elsewhere
  // (IR remote, pygame controller) via the /sensors poll.
  function applyModeUI(mode) {
    currentMode = mode;
    ['Manual','Auto','Line','Follow','Stay','Mind'].forEach(m => {
      const btn = document.getElementById('btn' + m);
      if (btn) btn.classList.toggle('active', m === mode);
    });
    updateDpadEnabled();
  }

  function setMode(mode) {
    cmd('/mode' + mode);
    applyModeUI(mode);
  }

  // /stop only works in Manual: anywhere else she's driving herself, so out of that first
  function stopNow() {
    if (currentMode !== 'Manual') setMode('Manual');
    cmd('/stop');
  }

  function updateDpadEnabled() {
    const enabled = currentMode === 'Manual' && !motorLocked;
    document.querySelectorAll('.btn:not(.stop-btn)').forEach(b => b.classList.toggle('disabled', !enabled));   // STOP always works
  }

  function applyLock() {
    const btn = document.getElementById('lockBtn');
    btn.textContent = motorLocked ? 'MOTOR LOCK: ON' : 'MOTOR LOCK: OFF';
    btn.className   = motorLocked ? 'locked' : 'unlocked';
    updateDpadEnabled();
  }

  function toggleLock() {
    if (motorLocked) {
      const pw = prompt('Enter password to unlock motors:');
      if (pw === null) return;
      fetch('/motorlockOff?pw=' + encodeURIComponent(pw)).then(r => {
        if (r.ok) { motorLocked = false; applyLock(); }
        else { alert('Wrong password — motors stay locked.'); }
      }).catch(() => {});
    } else {
      fetch('/motorlockOn').then(() => { motorLocked = true; applyLock(); }).catch(() => {});
    }
  }

  const uvLabels   = ['UV OFF', 'UV ON', 'UV BLINK'];
  const uvClasses  = ['', 'on', 'blink'];
  const uvRoutes   = ['/uvOff', '/uvOn', '/uvBlink'];

  function cycleUV() {
    uvState = (uvState + 1) % 3;
    applyUV();
    cmd(uvRoutes[uvState]);
  }

  function applyUV() {
    const btn = document.getElementById('uvBtn');
    btn.textContent = uvLabels[uvState];
    btn.className   = uvClasses[uvState];
  }

  function setSpeed(slider) {
    document.getElementById('speedVal').textContent = slider.value + '%';
    clearTimeout(speedTimer);
    speedTimer = setTimeout(() => cmd('/setspeed?v=' + slider.value), 200);
  }

  const speedPresets = [25, 50, 75, 100];
  let speedIndex = 3;   // matches the slider's hardcoded default of 100%

  function cycleSpeed() {
    speedIndex = (speedIndex + 1) % speedPresets.length;
    const v = speedPresets[speedIndex];
    document.getElementById('speedSlider').value = v;
    document.getElementById('speedVal').textContent = v + '%';
    cmd('/setspeed?v=' + v);
  }

  function setCal(slider, idx, labelId) {
    calVals[idx] = parseInt(slider.value);
    document.getElementById(labelId).textContent = calVals[idx];
    clearTimeout(calTimer);
    calTimer = setTimeout(() =>
      fetch(`/setcal?m1=${calVals[0]}&m2=${calVals[1]}&m3=${calVals[2]}&m4=${calVals[3]}`).catch(() => {})
    , 200);
  }

  function saveCal() {
    fetch('/savecal').then(() => {
      const btn = document.getElementById('saveCalBtn');
      btn.textContent = 'Saved!'; btn.classList.add('saved');
      setTimeout(() => { btn.textContent = 'Save'; btn.classList.remove('saved'); }, 1500);
    }).catch(() => {});
  }

  fetch('/getcal').then(r => r.json()).then(d => {
    [d.m1, d.m2, d.m3, d.m4].forEach((v, i) => {
      calVals[i] = v;
      document.getElementById('sl' + (i+1)).value = v;
      document.getElementById('v'  + (i+1)).textContent = v;
    });
    document.getElementById('speedSlider').value = d.spd;
    document.getElementById('speedVal').textContent = d.spd + '%';
  }).catch(() => {});

  function startCmd(c) {
    if (activeCmd === c) return;
    stopCmd();
    activeCmd = c;
    cmd(c);
    document.getElementById('status').textContent = c.replace('/', '').toUpperCase();
    cmdInterval = setInterval(() => cmd(c), 150);
  }

  function stopCmd() {
    if (activeCmd) {
      clearInterval(cmdInterval);
      activeCmd = null;
      cmd('/stop');
      document.getElementById('status').textContent = 'Idle';
    }
  }

  document.querySelectorAll('.btn').forEach(btn => {
    const c = btn.dataset.cmd;
    btn.addEventListener('mousedown',  e => { e.preventDefault(); c === '/stop' ? stopNow() : startCmd(c); btn.classList.add('pressed'); });
    btn.addEventListener('mouseup',    e => { e.preventDefault(); if (c !== '/stop') stopCmd(); btn.classList.remove('pressed'); });
    btn.addEventListener('mouseleave', e => { if (activeCmd === c && c !== '/stop') stopCmd(); btn.classList.remove('pressed'); });
    btn.addEventListener('touchstart', e => { e.preventDefault(); c === '/stop' ? stopNow() : startCmd(c); btn.classList.add('pressed'); }, { passive: false });
    btn.addEventListener('touchend',   e => { e.preventDefault(); if (c !== '/stop') stopCmd(); btn.classList.remove('pressed'); });
  });

  document.addEventListener('mouseup',  () => stopCmd());
  document.addEventListener('touchend', () => stopCmd());

  // ---- IDA link: same hold-to-drive rhythm as NORA's pad (resend every
  // 150 ms while held; IDA stops on her own ~0.5 s after the last one) ----
  let idaActive = null, idaTimer = null, linkRobot = 'ida';
  const LINK_COLOURS = { ida: '#D6935A', mila: '#1FD4DE', whip: '#D34859', kida: '#DF5BA3', nika: '#D9703A' };
  function ida(c) {
    fetch('/link?r=' + linkRobot + '&c=' + c).catch(() => {});
    document.getElementById('idaStatus').textContent = c;
  }
  // Pick which robot the panel drives: its avatar, name and colour follow
  function selectRobot(r) {
    idaStop();
    linkRobot = r;
    const av = document.getElementById('linkAvatar');
    av.onerror = function () { av.style.visibility = 'hidden'; };   // a robot without an avatar here yet
    av.onload = function () { av.style.visibility = ''; };
    av.src = '/avatar/' + r + '.jpg';
    av.alt = r.toUpperCase();
    document.getElementById('linkName').textContent = r.toUpperCase();
    document.getElementById('right').style.setProperty('--link', LINK_COLOURS[r]);
    document.getElementById('idaStatus').textContent = 'ready';
  }
  const LINK_ROBOTS = Object.keys(LINK_COLOURS);
  function stepRobot(by) {
    selectRobot(LINK_ROBOTS[(LINK_ROBOTS.indexOf(linkRobot) + by + LINK_ROBOTS.length) % LINK_ROBOTS.length]);
  }

  // ---- robots talking: the last few things NORA said, newest at the bottom ----
  function showTalk(t) {
    const lines = t.log.slice(-4).map(e => {
      const ago = Math.max(0, Math.round((t.now - e.ms) / 1000));
      return 'NORA &rarr; <b>' + e.to + '</b>: <code>' + e.bf + '</code> &rarr; &ldquo;' + e.text +
             '&rdquo; <span>(' + ago + ' s ago)</span>';
    });
    document.getElementById('talkLog').innerHTML = lines.join('<br>');
    showTalkSwitches(t);
  }
  // ---- her two talk switches (/talkmute; RIFT has the same): sound, and chat ----
  function showTalkSwitches(d) {
    if (d.talk_muted === undefined) return;
    document.getElementById('talkMuteBtn').textContent = d.talk_muted ? 'sound off' : 'sound on';
    document.getElementById('chatBtn').textContent = d.chat_off ? 'chat off' : 'chat on';
  }
  function talkSwitch(which) {
    fetch('/talkmute?' + which + '=toggle').then(r => r.json()).then(showTalkSwitches).catch(() => {});
  }
  function pollTalk() { fetch('/talk').then(r => r.json()).then(showTalk).catch(() => {}); }
  function sayHi() { fetch('/talk?r=' + linkRobot + '&p=hello').then(r => r.json()).then(showTalk).catch(() => {}); }
  pollTalk();
  setInterval(() => { if (!document.hidden) pollTalk(); }, 3000);
  function idaStart(c) {
    if (idaActive === c) return;
    idaStop(false);
    idaActive = c;
    ida(c);
    idaTimer = setInterval(() => ida(c), 150);
  }
  function idaStop(sendStop = true) {
    if (!idaActive) return;
    clearInterval(idaTimer);
    idaActive = null;
    if (sendStop) ida('stop');
  }
  document.querySelectorAll('.ida-btn').forEach(btn => {
    const c = btn.dataset.ida;
    const down = e => { e.preventDefault(); c === 'stop' ? (idaStop(false), ida('stop')) : idaStart(c); btn.classList.add('pressed'); };
    const up   = e => { e.preventDefault(); if (c !== 'stop') idaStop(); btn.classList.remove('pressed'); };
    btn.addEventListener('mousedown', down);
    btn.addEventListener('mouseup', up);
    btn.addEventListener('mouseleave', e => { if (idaActive === c) idaStop(); btn.classList.remove('pressed'); });
    btn.addEventListener('touchstart', down, { passive: false });
    btn.addEventListener('touchend', up);
  });
  const idaKeys = { 'i': 'fw', 'k': 'bw', 'j': 'left', 'l': 'right' };
  document.addEventListener('keydown', e => {
    const c = idaKeys[e.key.toLowerCase()];
    if (c && !e.repeat) { e.preventDefault(); idaStart(c); }
  });
  document.addEventListener('keyup', e => {
    if (idaKeys[e.key.toLowerCase()] === idaActive) idaStop();
  });

  const keyMap = {
    'arrowup':'/fw', 'arrowdown':'/bw', 'arrowleft':'/left', 'arrowright':'/right',
    'w':'/fw', 's':'/bw', 'a':'/left', 'd':'/right',
    'q':'/turnL', 'e':'/turnR'
  };
  document.addEventListener('keydown', e => {
    const k = e.key.toLowerCase();

    // ---- always-allowed controls: mirror the physical remote, where
    // music/UV/mode switching work no matter which drive mode is active ----
    if (k === 'tab') { e.preventDefault(); stepRobot(e.shiftKey ? -1 : 1); return; }
    if (k === ' ') { e.preventDefault(); cmd('/muPlay'); return; }
    if (k === 'm') { e.preventDefault(); cmd('/muNext'); return; }
    if (k === 'u') { e.preventDefault(); cycleUV();      return; }
    if (k === 'x') { e.preventDefault(); cycleSpeed();   return; }
    if (k === '1') { e.preventDefault(); setMode('Manual'); return; }
    if (k === '2') { e.preventDefault(); setMode('Auto');   return; }
    if (k === '3') { e.preventDefault(); setMode('Line');   return; }
    if (k === '4') { e.preventDefault(); setMode('IR');     return; }

    // ---- driving: Manual mode only, same rule as the D-pad ----
    const c = keyMap[k];
    if (!c || currentMode !== 'Manual') return;
    e.preventDefault();
    startCmd(c);
  });
  document.addEventListener('keyup', e => { if (keyMap[e.key.toLowerCase()]) stopCmd(); });

  function updateSensor(boxId, barId, spanId, value) {
    const box = document.getElementById(boxId);
    const bar = document.getElementById(barId);
    document.getElementById(spanId).textContent = value > 0 ? value : '--';

    box.classList.remove('warn', 'crit');
    if (value > 0 && value < 15)  box.classList.add('crit');
    else if (value > 0 && value < 28) box.classList.add('warn');

    const pct = value > 0 ? Math.min(value / 100 * 100, 100) : 0;
    bar.style.width = pct + '%';
    bar.style.background = value > 0 && value < 15 ? 'var(--red)' : 'var(--accent)';
  }

  // The "from above" view: a line at each side, as far off as the sonar says (out to 80 cm)
  function placeWall(id, x1, y1, x2, y2) {
    const w = document.getElementById(id);
    w.setAttribute('x1', x1); w.setAttribute('y1', y1); w.setAttribute('x2', x2); w.setAttribute('y2', y2);
  }
  function drawWalls(d) {
    const out = v => 34 + Math.min(v > 0 ? v : 80, 80) * 0.65;
    const F = 120 - out(d.F), B = 120 + out(d.B), L = 100 - out(d.L), R = 100 + out(d.R);
    placeWall('wallF', 70, F, 130, F); placeWall('wallB', 70, B, 130, B);
    placeWall('wallL', L, 90, L, 150); placeWall('wallR', R, 90, R, 150);
  }

  // Who's on her network, as the Python controller's FLEET lines
  function pollFleet() {
    fetch('/near').then(r => r.json()).then(d => {
      const near = (d.robots || []).map(r => '&bull; ' + r.name + ' (' + r.rssi + ' dBm)');
      document.getElementById('fleetBox').innerHTML = 'FLEET &nbsp;<b>authority: NORA (self)</b><br>' + near.join('<br>');
    }).catch(() => {});
  }
  pollFleet();
  setInterval(() => { if (!document.hidden) pollFleet(); }, 5000);

  const msLabels  = ['stopped', 'playing', 'paused'];
  const msClasses = ['', 'playing', 'paused'];

  function updateSensors() {
    fetch('/sensors').then(r => r.json()).then(d => {
      updateSensor('boxF', 'barF', 'sF', d.F);
      updateSensor('boxB', 'barB', 'sB', d.B);
      updateSensor('boxL', 'barL', 'sL', d.L);
      updateSensor('boxR', 'barR', 'sR', d.R);
      drawWalls(d);

      document.getElementById('lfL').classList.toggle('on', d.lfl === 1);
      document.getElementById('lfM').classList.toggle('on', d.lfm === 1);
      document.getElementById('lfR').classList.toggle('on', d.lfr === 1);

      document.getElementById('lightVal').textContent = d.lt + '%';
      document.getElementById('sndDot').classList.toggle('on', d.snd === 1);

      document.getElementById('tempVal').textContent = d.temp >= 0 ? d.temp : '--';
      document.getElementById('humVal').textContent  = d.hum  >= 0 ? d.hum  : '--';

      dirBox.forEach(id => document.getElementById(id).classList.remove('travel'));
      if (d.mode === 1) document.getElementById(dirBox[d.dir]).classList.add('travel');

      // Reflect state that may have changed from elsewhere -- the IR remote,
      // the pygame controller -- so this page never shows a stale mode/UV/
      // speed after someone else drove the change. Only *apply* the UI here,
      // never re-send the command (that would just echo it back out).
      document.getElementById('btnMind').style.display = d.mindHost ? '' : 'none';   // only while her controller can think
      const srvMode = modeNames[d.mode];
      if (srvMode && srvMode !== currentMode) applyModeUI(srvMode);

      if (d.uv !== uvState) { uvState = d.uv; applyUV(); }

      if (typeof d.spd === 'number' && d.spd !== speedPresets[speedIndex]) {
        const nearest = speedPresets.reduce((best, v, i) =>
          Math.abs(v - d.spd) < Math.abs(speedPresets[best] - d.spd) ? i : best, 0);
        speedIndex = nearest;
        document.getElementById('speedSlider').value = d.spd;
        document.getElementById('speedVal').textContent = d.spd + '%';
      }

      const lockState = d.lock === 1;
      if (lockState !== motorLocked) { motorLocked = lockState; applyLock(); }

      document.getElementById('musicTrack').textContent = 'track' + String(d.mt).padStart(3, '0');
      const st = document.getElementById('musicState');
      st.textContent = msLabels[d.ms]  || 'stopped';
      st.className   = msClasses[d.ms] || '';
    }).catch(() => {});
  }
  // once a second, and not at all while the tab is hidden: her one-at-a-time web
  // server is shared with RIFT, NINA and the other pages
  setInterval(() => { if (!document.hidden) updateSensors(); }, 1000);
  updateSensors();
</script>
</body>
</html>
)rawhtml";

void handleRoot() {
  // Without no-delay the page leaves in ~1.4 KB pieces, each held back
  // waiting on the browser's delayed ACK: ~10 s for the page, with the
  // whole loop (and RIFT's 2 s probes) stuck behind it.
  server.client().setNoDelay(true);
  server.send_P(200, "text/html", INDEX_HTML);
}

// =====================
// MANUAL/REMOTE CRASH PREVENTION
// =====================
// Auto and Line already have their own obstacle handling (see
// AutonomousMode()/LineFollowerMode()), so this only applies when a human
// is actually driving -- Manual (website/app/BT) or Remote (physical IR).
// Turning in place is left alone: there's no sensor that maps to "the
// direction you're rotating into", and blocking it could trap someone
// against a wall with no way to reorient.
// (MANUAL_STOP_CM, 15 cm, is defined up with DRIVE MODE -- Line mode uses it too.)

bool blockedInDir(int dir) {
  if (driveMode != MODE_MANUAL && driveMode != MODE_IR && driveMode != MODE_MIND && driveMode != MODE_FOLLOW && driveMode != MODE_STAY) return false;
  float d;
  switch (dir) {
    case DIR_FRONT: d = front_cm; break;
    case DIR_RIGHT: d = right_cm; break;
    case DIR_BACK: d = back_cm; break;
    case DIR_LEFT: d = left_cm; break;
    default: return false;
  }
  return (d > 0 && d < MANUAL_STOP_CM);  // d <= 0 means "no valid reading" -- don't
                                         // block on sensor noise, only a real reading
}

// =====================
// MOVEMENT FUNCTIONS
// =====================
void moveForward(int scale) {
  if (blockedInDir(DIR_FRONT)) {
    stopMotors();
    Serial.println("BZ:DENIED");
    return;
  }
  setMotor(ENA1, M1_1, M1_2, LOW, HIGH, cal[0], scale);
  setMotor(ENA2, M2_1, M2_2, LOW, HIGH, cal[1], scale);
  setMotor(ENB1, M3_1, M3_2, HIGH, LOW, cal[2], scale);
  setMotor(ENB2, M4_1, M4_2, HIGH, LOW, cal[3], scale);
}
void moveBackward(int scale) {
  if (blockedInDir(DIR_BACK)) {
    stopMotors();
    Serial.println("BZ:DENIED");
    return;
  }
  setMotor(ENA1, M1_1, M1_2, HIGH, LOW, cal[0], scale);
  setMotor(ENA2, M2_1, M2_2, HIGH, LOW, cal[1], scale);
  setMotor(ENB1, M3_1, M3_2, LOW, HIGH, cal[2], scale);
  setMotor(ENB2, M4_1, M4_2, LOW, HIGH, cal[3], scale);
}
void strafeLeft(int scale) {
  if (blockedInDir(DIR_LEFT)) {
    stopMotors();
    Serial.println("BZ:DENIED");
    return;
  }
  setMotor(ENA1, M1_1, M1_2, HIGH, LOW, cal[0], scale);
  setMotor(ENA2, M2_1, M2_2, LOW, HIGH, cal[1], scale);
  setMotor(ENB1, M3_1, M3_2, HIGH, LOW, cal[2], scale);
  setMotor(ENB2, M4_1, M4_2, LOW, HIGH, cal[3], scale);
}
void strafeRight(int scale) {
  if (blockedInDir(DIR_RIGHT)) {
    stopMotors();
    Serial.println("BZ:DENIED");
    return;
  }
  setMotor(ENA1, M1_1, M1_2, LOW, HIGH, cal[0], scale);
  setMotor(ENA2, M2_1, M2_2, HIGH, LOW, cal[1], scale);
  setMotor(ENB1, M3_1, M3_2, LOW, HIGH, cal[2], scale);
  setMotor(ENB2, M4_1, M4_2, HIGH, LOW, cal[3], scale);
}
void turnLeft(int scale) {
  setMotor(ENA1, M1_1, M1_2, HIGH, LOW, cal[0], scale);
  setMotor(ENA2, M2_1, M2_2, LOW, HIGH, cal[1], scale);
  setMotor(ENB1, M3_1, M3_2, LOW, HIGH, cal[2], scale);
  setMotor(ENB2, M4_1, M4_2, HIGH, LOW, cal[3], scale);
}
void turnRight(int scale) {
  setMotor(ENA1, M1_1, M1_2, LOW, HIGH, cal[0], scale);
  setMotor(ENA2, M2_1, M2_2, HIGH, LOW, cal[1], scale);
  setMotor(ENB1, M3_1, M3_2, HIGH, LOW, cal[2], scale);
  setMotor(ENB2, M4_1, M4_2, LOW, HIGH, cal[3], scale);
}

// One wheel at v (-1..1, + = that wheel's forward); flip: its forward is HIGH, LOW (M3, M4)
void wheel(int ena, int pin1, int pin2, bool flip, float v, int calSpeed) {
  const bool fwd = v >= 0;
  const int s1 = (fwd != flip) ? LOW : HIGH;
  setMotor(ena, pin1, pin2, s1, s1 == LOW ? HIGH : LOW, calSpeed, (int)(fabsf(v) * 100));
}

// Mecanum mixing for /drive: forward, sideways (+ left) and turning (+ anticlockwise) together.
// From the four moves above: M1 = f - s - t, M2 = f + s + t, M3 = f + s - t, M4 = f - s + t, scaled
// so no wheel goes past full. A direction with a wall in it (blockedInDir) is dropped, the rest kept.
void driveMix(float f, float s, float t) {
  if ((f > 0 && blockedInDir(DIR_FRONT)) || (f < 0 && blockedInDir(DIR_BACK))) f = 0;
  if ((s > 0 && blockedInDir(DIR_LEFT)) || (s < 0 && blockedInDir(DIR_RIGHT))) s = 0;
  float v[4] = { f - s - t, f + s + t, f + s - t, f - s + t };
  float m = 1;
  for (int i = 0; i < 4; i++) m = max(m, fabsf(v[i]));
  if (fabsf(f) + fabsf(s) + fabsf(t) < 0.05f) { stopMotors(); return; }
  wheel(ENA1, M1_1, M1_2, false, v[0] / m, cal[0]);
  wheel(ENA2, M2_1, M2_2, false, v[1] / m, cal[1]);
  wheel(ENB1, M3_1, M3_2, true,  v[2] / m, cal[2]);
  wheel(ENB2, M4_1, M4_2, true,  v[3] / m, cal[3]);
}

void stopMotors() {
  webDriveMs = 0;
  showMove = SHOW_NONE;
  motorsMoving = false;
  analogWrite(ENA1, 0);
  digitalWrite(M1_1, LOW);
  digitalWrite(M1_2, LOW);
  analogWrite(ENA2, 0);
  digitalWrite(M2_1, LOW);
  digitalWrite(M2_2, LOW);
  analogWrite(ENB1, 0);
  digitalWrite(M3_1, LOW);
  digitalWrite(M3_2, LOW);
  analogWrite(ENB2, 0);
  digitalWrite(M4_1, LOW);
  digitalWrite(M4_2, LOW);
}

void setMotor(int ena, int pin1, int pin2, int s1, int s2, int speed, int scale) {
  if (motorLocked) {
    analogWrite(ena, 0);
    digitalWrite(pin1, LOW);
    digitalWrite(pin2, LOW);
    return;
  }
  int pwm = (speed * speedPct * scale) / 10000;
  if (pwm > 0) motorsMoving = true;
  analogWrite(ena, pwm);
  digitalWrite(pin1, s1);
  digitalWrite(pin2, s2);
}
