CursedPrograms/NORA-Robot-v00/scripts/esp32/avatars.h

// Avatars of the robots NORA drives over the IR link, served at /avatar/<name>.jpg
// for the fleet-remote panel. Generated from each robot's images/ -- regenerate, don't edit.
#pragma once
#include <pgmspace.h>

static const uint8_t AVATAR_IDA[] PROGMEM = {
  0xFF, 0xD8, 0xFF, 0xE0, 0x00, 0x10, 0x4A, 0x46, 0x49, 0x46, 0x00, 0x01, 0x01, 0x00, 0x00, 0x01,
  0x00, 0x01, 0x00, 0x00, 0xFF, 0xDB, 0x00, 0x43, 0x00, 0x06, 0x04, 0x05, 0x06, 0x05, 0x04, 0x06,
  0x06, 0x05, 0x06, 0x07, 0x07, 0x06, 0x08, 0x0A, 0x10, 0x0A, 0x0A, 0x09, 0x09, 0x0A, 0x14, 0x0E,
  0x0F, 0x0C, 0x10, 0x17, 0x14, 0x18, 0x18, 0x17, 0x14, 0x16, 0x16, 0x1A, 0x1D, 0x25, 0x1F, 0x1A,
  0x1B, 0x23, 0x1C, 0x16, 0x16, 0x20, 0x2C, 0x20, 0x23, 0x26, 0x27, 0x29, 0x2A, 0x29, 0x19, 0x1F,
  0x2D, 0x30, 0x2D, 0x28, 0x30, 0x25, 0x28, 0x29, 0x28, 0xFF, 0xDB, 0x00, 0x43, 0x01, 0x07, 0x07,
  0x07, 0x0A, 0x08, 0x0A, 0x13, 0x0A, 0x0A, 0x13, 0x28, 0x1A, 0x16, 0x1A, 0x28, 0x28, 0x28, 0x28,
  0x28, 0x28, 0x28, 0x28, 0x28, 0x28, 0x28, 0x28, 0x28, 0x28, 0x28, 0x28, 0x28, 0x28, 0x28, 0x28,
  0x28, 0x28, 0x28, 0x28, 0x28, 0x28, 0x28, 0x28, 0x28, 0x28, 0x28, 0x28, 0x28, 0x28, 0x28, 0x28,
  0x28, 0x28, 0x28, 0x28, 0x28, 0x28, 0x28, 0x28, 0x28, 0x28, 0x28, 0x28, 0x28, 0x28, 0xFF, 0xC0,
  0x00, 0x11, 0x08, 0x00, 0x60, 0x00, 0x60, 0x03, 0x01, 0x22, 0x00, 0x02, 0x11, 0x01, 0x03, 0x11,
  0x01, 0xFF, 0xC4, 0x00, 0x1B, 0x00, 0x00, 0x03, 0x01, 0x01, 0x01, 0x01, 0x01, 0x00, 0x00, 0x00,
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
  0xF4, 0x35, 0xC4, 0xAB, 0x56, 0x0C, 0x12, 0xEC, 0x92, 0x12, 0x3C, 0xC9, 0xA5, 0xB6, 0x3F, 0xF6,
  0x2F, 0xB8, 0x26, 0x82, 0xA1, 0x15, 0xE0, 0x9A, 0x39, 0x55, 0x94, 0x30, 0x28, 0xE0, 0xF0, 0x7C,
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
};
