CursedPrograms/NORA-Robot-v00/(commit log)

2026-10-04 README matches the firmware; avatar icons and site update
    - Avatar as the site favicon / Apple touch icon, and images/nora.ico for programs
    - GitHub Pages site: CSS and JS split into site/, matching 404.html and 500.html
    - Avatar and controller screenshots in the README and on the site
    - colour_scheme.xml sampled from the avatar
    - README: pinout, sensors, modes (1-4), serial protocol and endpoints rewritten from esp32.ino / arduino.ino
    - Python controller: avatar window icon
    - Rename clear-commits scripts; stop ignoring site/ (mkdocs rule)
2026-10-04 IDA link: NORA drives IDA over her IR transmitter
    Firmware sends Samsung-format frames (address 0x0DA1) on GPIO 33 via
    /ida?c=..., the web page's IDA panel (I/J/K/L) and the BT 'I' prefix,
    and ignores its own frames. The Python controller gets an IDA column
    with avatars. README and site document the link.
2026-10-04 NORA talks to IDA over IR + buzzer
    Every 30-90 s when idle she chirps a phrase (UNO BZ:TALK:n melodies) and sends it over the link (0x40-0x46); a silent 'I am here' beacon (0x47) goes round the fleet in between. GET /talk returns the conversation log, /talk?r=&p= says one now; the fleet panel shows the latest lines and has SAY HI. Claps are ignored while she talks so the chirps don't start the music.
    [arduino.ino, esp32.ino]
2026-10-04 TODO: IR steering and the presence beacon are done
2026-10-04 Talk in Brainfuck; /chirp for RIFT
    Phrases are now Brainfuck programs beeped one tone per symbol (talk_bf.h). NORA sends the IR phrase once she has finished saying it so IDA doesn't talk over her; /talk includes the program and what it prints; GET /chirp?u= lets RIFT have her speak in WiFi conversations.
    [arduino.ino, esp32.ino]
2026-10-04 flash.bat: compile + flash the ESP32, talking you through it
    Speaks each step (hold boot / connected, let go / progress / done or failed, with retries) so you can watch the board instead of the screen. Builds into build/esp32 so only changes recompile, and skips the compile entirely when no sketch file changed since the last build.
2026-10-04 IR obeys only NORA's remote, line mode stops for walls, faster web page, MP3 voice
    - handleIR: only NEC address 0x00 frames count; noise decoded as other
    protocols was switching her into Line mode on its own
    - setDriveMode(): one place for mode changes, records the source (msrc)
    - Line mode stops for anything closer than 15 cm in front
    - TCP no-delay for the page and avatars: 10 s -> fast, so the loop and
    RIFT's 2 s probes aren't stuck behind it
    - UNO plays spoken lines (track200+) for mode/lock/UV/blocked, beeps if
    missing; make_voice.bat makes them with Windows TTS + ffmpeg
    [arduino.ino, esp32.ino]
2026-10-04 TODO: tonight's fixes, voice still to install, UV blink and left sonar to check
2026-10-04 WHO handshake: NORA answers "I am Nora" on her USB port
    parseSensorLine() also ignores lines that aren't the UNO's F:... status
    line, which used to reset every reading to -1.
    [esp32.ino]
2026-10-14 M:TRACK for music together; site styles
    arduino.ino: M:TRACK:<n> plays track n from the start, so RIFT can start her on
    the same moment as the rest of the fleet (compiles: 74% flash; not flashed yet).
    Ecosystem block styles moved into site/style.css.
2026-10-18 Fleet WiFi ladder (virtual bots, controllers), climbs again when her network goes quiet, fleet track numbers
2026-10-19 Keys page (/keys) and window (F1), gamepad drive, lock/unlock the fleet's wheels; round avatar
2026-10-19 flash.bat sets itself up on a fresh PC: arduino-cli, the ESP32 core (3.3.12) and the libraries
    No Arduino IDE needed: it downloads arduino-cli once, installs esp32:esp32@3.3.12 and the sketch's
    libraries ($Libs) when they're missing, and puts libraries next to the cores when Documents can't be
    written to (Windows Security's controlled folder access). Tested from nothing on Windows 11.
2026-10-19 NIKA joins the fleet: the bottom of the WiFi ladder, the give-way rule (she can't hear ESP-NOW, like MILA), the radar lists, NORA's IR link (0x0DA5), RIFT's port 5013 / relay / personality, the ecosy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
2026-10-19 Her remote's 5 toggles the wheel lock: one button, no PIN
    Locked, her remote couldn't drive her and nothing on it could free her (it took the web page, the
    controller or Bluetooth V1234). The lock is a safety catch, not security. Keys page and README too.
2026-10-20 MIND mode, and IDA's mind: her controller's LLM drives her (N), and IDA, blind, over the IR link (H)
    - esp32.ino: MODE_MIND, /unlock?pw=&ctl=1 (her mind's controller), /sensors?ctl=1 check-in, /mind?act=
    fw|bw|left|right|turnL|turnR|stop&steps=, /mode?m= and /modeMind; her wheel lock and wall stop hold;
    MIND ends when the controller goes quiet; the MIND button on her page only while it's there
    - controller.py: her mind (the fleet's boss, Zira) and IDA's (timid sidekick: she senses nothing, so one
    short step at a time); mind_panel.py draws the thinking
    - make_voice.ps1: her mind's phrase book, lines 11-31 (PHRASEBOOK_ON_CARD once they're on the card)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
2026-10-24 Controller: W+A blends, EMULATE, takes over, STOP in any mode, themes; /drive
    Firmware: /drive?f=&s=&t= mixes forward, sideways and turning over the four
    mecanum wheels (W+A forward + slide left, W+Q a curve), drops a direction with
    a wall in it, and stops by itself 0.5 s after the last one. Compiles, not flashed.
    Controller: held keys and the pad's stick blend (falls back to one move at a time
    on firmware without /drive); driving in AUTO / LINE / IR takes over (MANUAL, stops
    on release); STOP in any mode; mode / UV / speed re-sent until /sensors confirms;
    DEFAULT / LIGHT / CUSTOM themes from colour_scheme.xml; EMULATE (fake_nora.py) on
    the connection screen or --emulate. Session test: 23 s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
2026-10-24 README: ACEBOTT's Getting started with ESP32 page, with the board's other docs
2026-10-26 controller_kit.py: the pretend robot takes POSTs, images and streams
    FakeRobot's route() can now answer bytes (an image), a generator (streamed:
    an MJPEG camera) or a content type of its own, and gets POSTs too (q["_body"],
    q["_json"]). KIDA-00's EMULATE needs them; every robot's fake works as before.
    The same file in every controller (fleet TODO section 13).
2026-10-28 NORA: speed on her remote (6 / 7), and Auto keeps off the side walls and stops sooner
    Auto stopped at 15 cm and scraped walls beside her: now she slows from 40 cm, stops at 22, and
    slides away from a wall beside her from 20 cm (mecanum: going on while she slides), only sliding
    under 9 cm. Compiles; not flashed.
2026-10-30 NORA: FOLLOW mode, HELLO and DANCE, /status, nora.local
    FOLLOW keeps a hand 30 cm from her front sonar, inside her wall stop. /act?do=hello|dance wiggle on
    the spot a step at a time from loop(). /status is the same JSON as /sensors.
2026-10-30 NORA: rev in /status and /sensors, her settings in one number
2026-10-30 NORA: avatar splash in her app, her MP3 board is a VS1053 with line in
2026-10-30 NORA: her ESP32 page looks like her Python controller
2026-11-04 The fleet's one Bluetooth protocol, smart STAY CLOSE, wifi_rssi
    - Her one-letter Bluetooth commands are replaced by fleet_bt: every web command over Bluetooth, ":5000/..." her fleet list
    - Her controller's BtLink is her WifiLink over Bluetooth (blended driving, speed, fleet panel, MIND)
    - STAY CLOSE slides round things with her four sonars; /status has distance_cm, wifi_rssi, bluetooth
    - The fleet's WiFi ladder has a RITA rung (between the controllers and NORA): robots join her when she hosts
2026-11-05 Controller exe: close together with the server it started
    The exe and its server live and die together: closing the exe ends the run.bat it started (a job object), and closing the server's window closes the exe.
2026-11-08 Talk switches (BZ:MUTE to the UNO); fleet_radio.h; TEMP heap lines out
